Annex-Engineering/Denali/DXFs/Electronics_Backpack/electronics_box_side_panel_decorative_x2_rev1.DXF

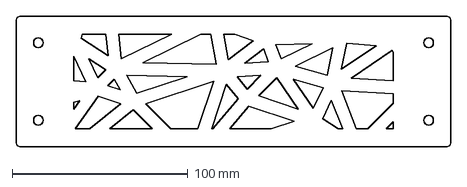
[picture p5: CAD file, 2020-09-06]
DXFs/Electronics_Backpack/electronics_box_side_panel_decorative_x2_rev1.DXF
247.0 x 74.0 mm
