Annex-Engineering/Denali/DXFs/Panels/Deck_Panel_350mm_Rev1.DXF

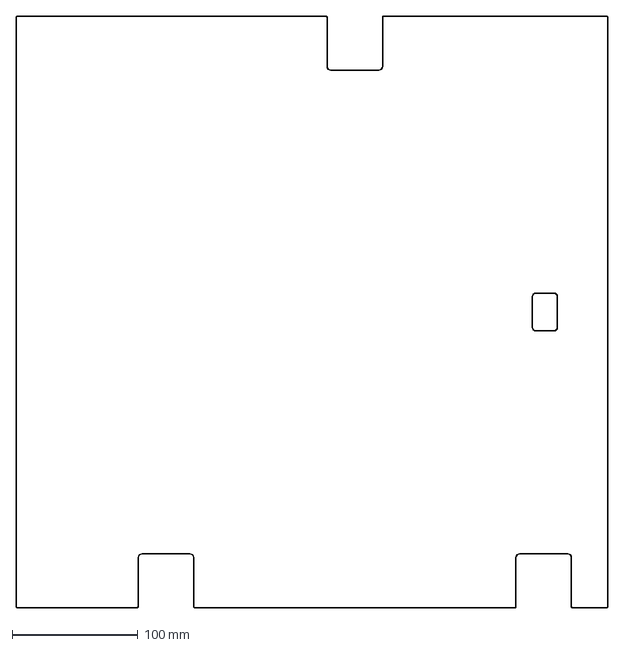
[picture p6: CAD file, 2020-09-06]
DXFs/Panels/Deck_Panel_350mm_Rev1.DXF
470.0 x 470.0 mm
