Annex-Engineering/Denali/STLs/Bed_and_Z_Drive/sfu1204_bed_pivot_joint_x1_Rev2.stl

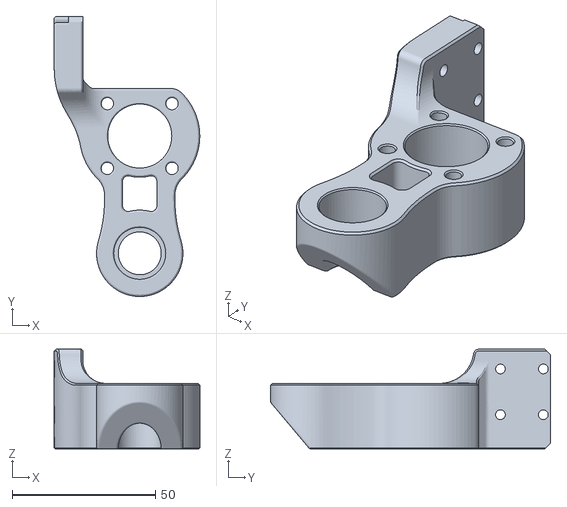
[picture p8: CAD file, 2020-09-06]
STLs/Bed_and_Z_Drive/sfu1204_bed_pivot_joint_x1_Rev2.stl
50.9 x 97.9 x 34.9
