Annex-Engineering/Denali/STLs/Display_Housing/fystec_mini_12864_housing_x1_Rev1.stl

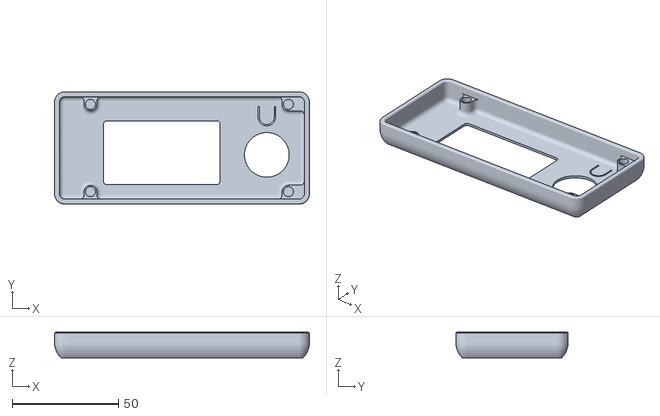
[picture p9: CAD file, 2020-09-06]
STLs/Display_Housing/fystec_mini_12864_housing_x1_Rev1.stl
119.8 x 52.8 x 12.0
