Annex-Engineering/Denali/STLs/Electronics_Brackets/[a]_electronics_box_corner_x4_rev7.STL

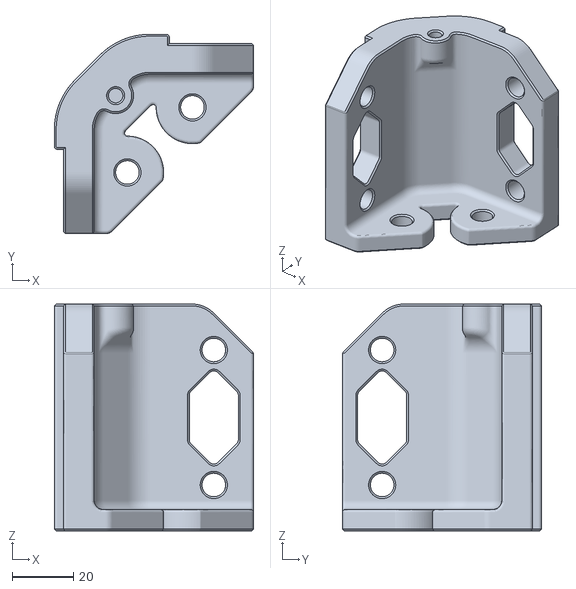
[picture p10: CAD file, 2022-02-27]
STLs/Electronics_Brackets/[a]_electronics_box_corner_x4_rev7.STL
65.0 x 65.0 x 74.0
