Annex-Engineering/Denali/STLs/Electronics_Mounting/bigtreetech_skr_mounting_bracket_x2_rev4.STL

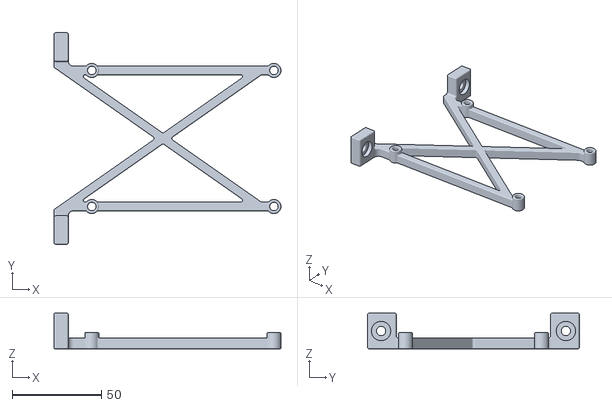
[picture p11: CAD file, 2021-05-22]
STLs/Electronics_Mounting/bigtreetech_skr_mounting_bracket_x2_rev4.STL
127.0 x 118.3 x 20.0
