Annex-Engineering/Denali/STLs/Filament_Management/External_to_Chamber/spool_holder_6mm_panels_x1_Rev1.stl

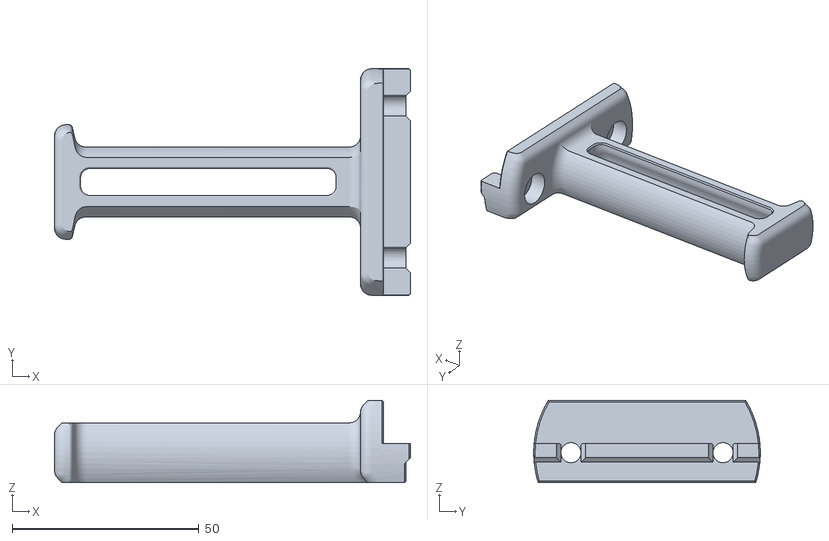
[picture p12: CAD file, 2020-09-06]
STLs/Filament_Management/External_to_Chamber/spool_holder_6mm_panels_x1_Rev1.stl
95.4 x 60.7 x 22.0
