Annex-Engineering/Denali/STLs/Filament_Management/In-Chamber/bowden_holder_in_chamber_spools_x1_rev1.STL

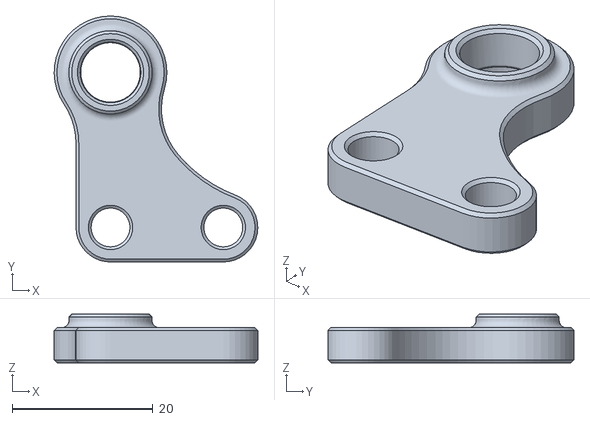
[picture p13: CAD file, 2020-09-06]
STLs/Filament_Management/In-Chamber/bowden_holder_in_chamber_spools_x1_rev1.STL
28.9 x 34.9 x 6.90
