Annex-Engineering/Denali/STLs/Gantry/AB_Drives/a_drive_frame_upper_x1_Rev2.stl

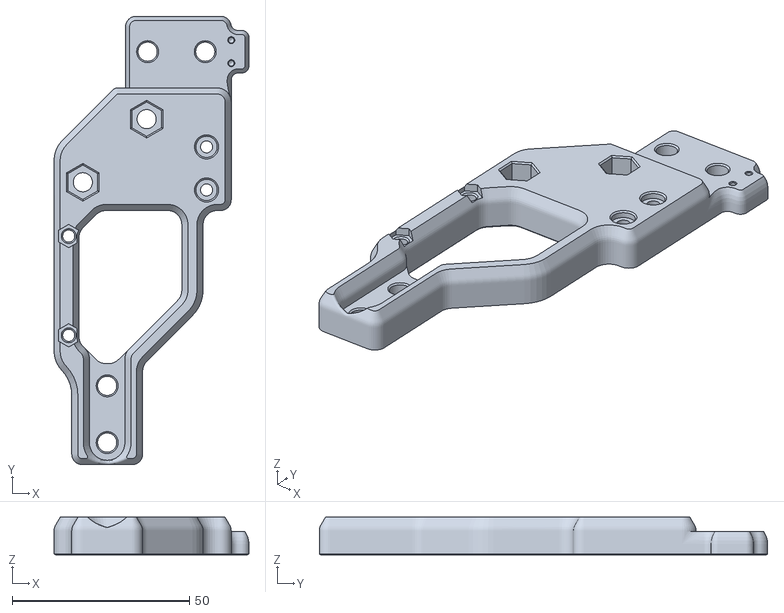
[picture p14: CAD file, 2020-09-06]
STLs/Gantry/AB_Drives/a_drive_frame_upper_x1_Rev2.stl
55.0 x 126.5 x 10.6
