Annex-Engineering/Denali/STLs/Gantry/Toolheads/mosquito_sherpa_mini_mount_rev1_x1.STL

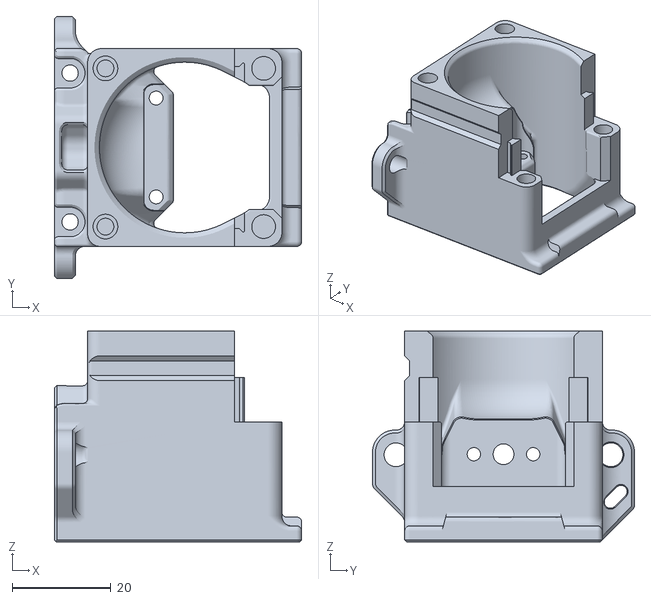
[picture p16: CAD file, 2021-01-14]
STLs/Gantry/Toolheads/mosquito_sherpa_mini_mount_rev1_x1.STL
50.0 x 53.0 x 42.6
