Annex-Engineering/Denali/STLs/Gantry/X_Carriage/x_carriage_left_mag_microswitch_rev1_x1.stl

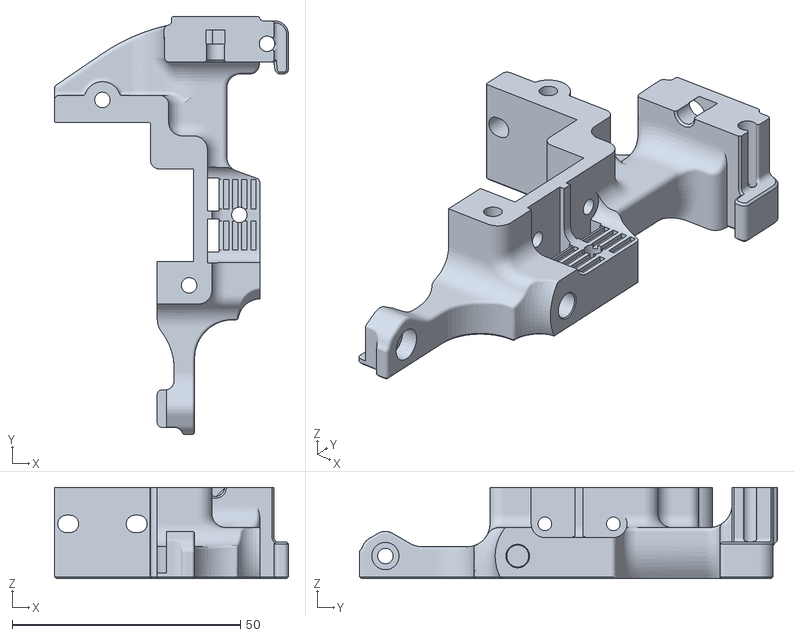
[picture p17: CAD file, 2021-01-16]
STLs/Gantry/X_Carriage/x_carriage_left_mag_microswitch_rev1_x1.stl
51.3 x 91.6 x 20.0
