Annex-Engineering/Denali/STLs/Gantry/XY_Joints/left_xy_joint_bottom_Rev3.stl

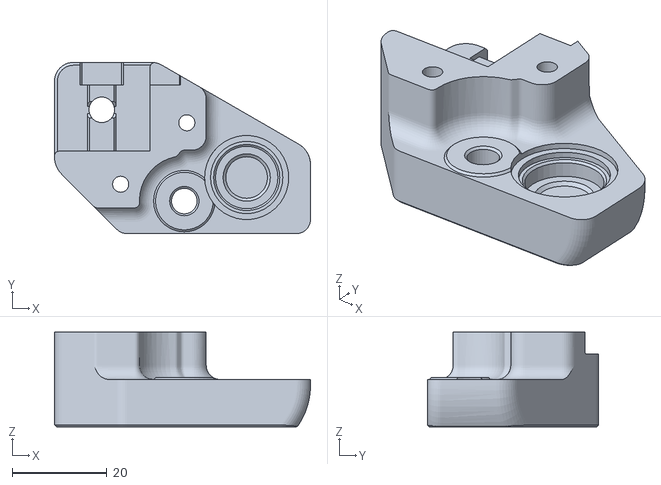
[picture p18: CAD file, 2020-09-06]
STLs/Gantry/XY_Joints/left_xy_joint_bottom_Rev3.stl
54.2 x 36.2 x 20.0
