Annex-Engineering/Denali/STLs/Magnetic_Probe_and_Dock/[a]_magnetic_probe_x1_rev1.STL

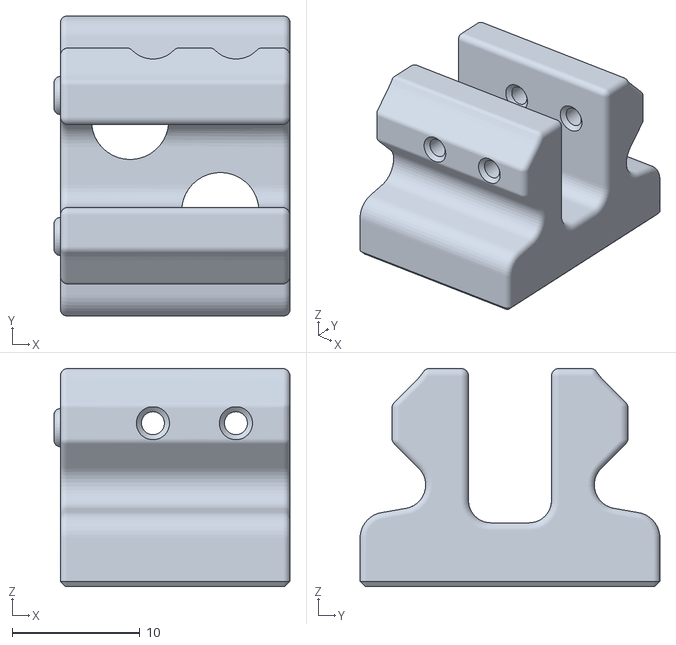
[picture p19: CAD file, 2020-09-06]
STLs/Magnetic_Probe_and_Dock/[a]_magnetic_probe_x1_rev1.STL
18.5 x 23.5 x 17.1
