Annex-Engineering/Denali/STLs/Misc/[a]_x_rail_installation_guide_x2_Rev2.stl

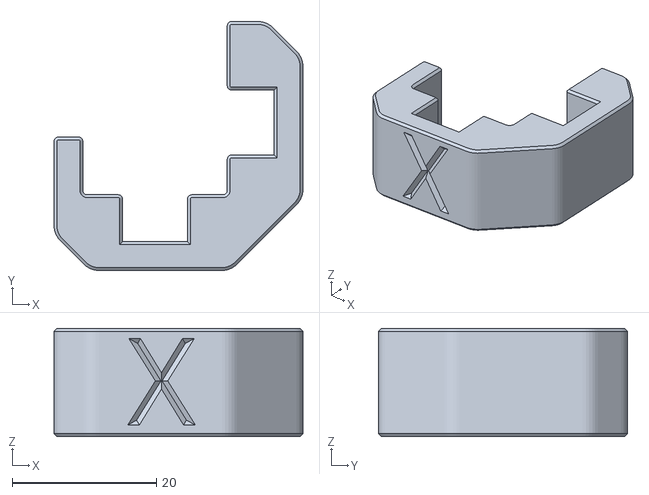
[picture p20: CAD file, 2020-09-06]
STLs/Misc/[a]_x_rail_installation_guide_x2_Rev2.stl
34.5 x 34.5 x 15.0
