Annex-Engineering/Denali/STLs/Panel_Mounting/Front_Panel_Hinges_and_Locks/Hinges/hinge_frame_bottom_6mm_x2_rev1.STL

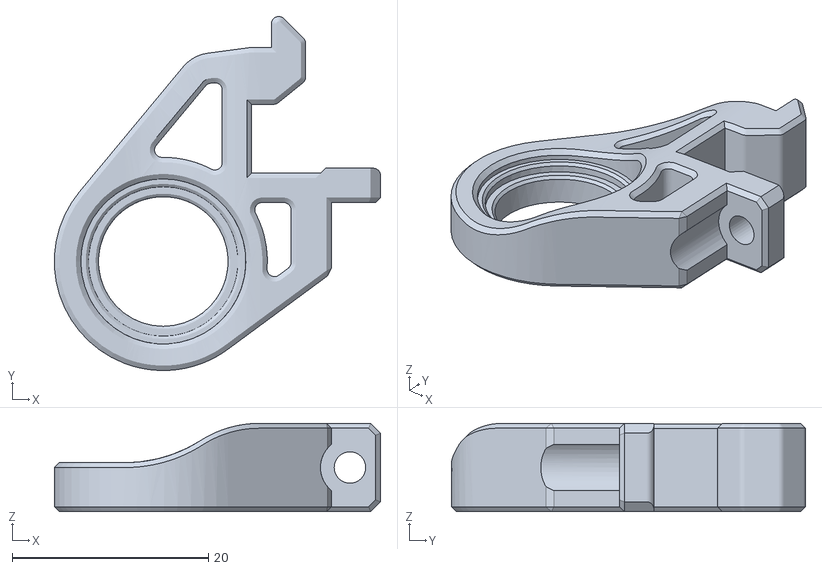
[picture p21: CAD file, 2020-09-06]
STLs/Panel_Mounting/Front_Panel_Hinges_and_Locks/Hinges/hinge_frame_bottom_6mm_x2_rev1.STL
33.2 x 36.0 x 9.00
