Annex-Engineering/Denali/STLs/Panel_Mounting/Front_Panel_Hinges_and_Locks/Locks/lock_body_6mm_x2_Rev1.stl

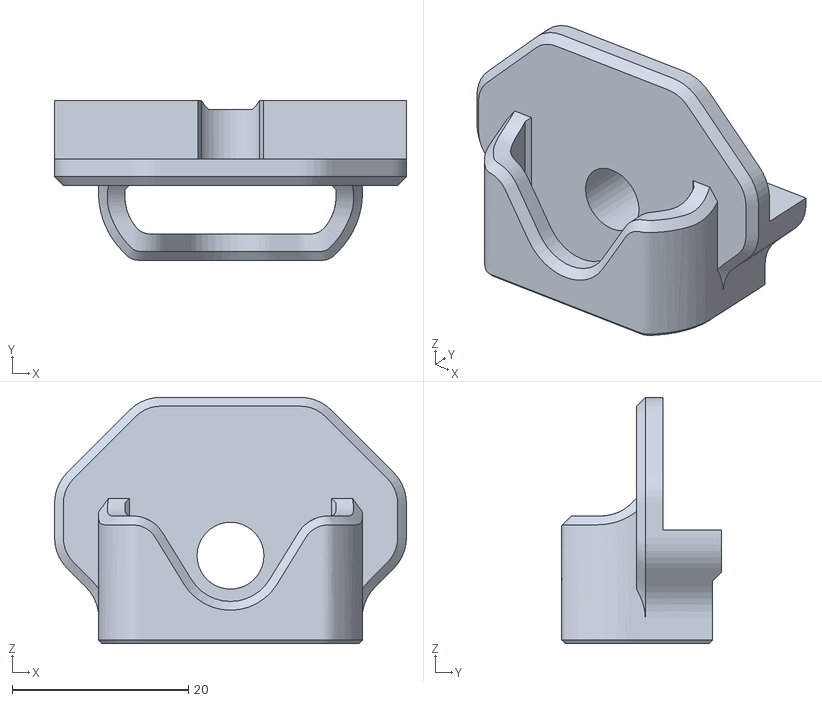
[picture p22: CAD file, 2020-09-06]
STLs/Panel_Mounting/Front_Panel_Hinges_and_Locks/Locks/lock_body_6mm_x2_Rev1.stl
40.0 x 18.1 x 28.0
