Annex-Engineering/Denali/STLs/Panel_Mounting/Side_Top_and_Rear_Panel_Quick_Release/lock_body_6mm_x20_Rev2.stl

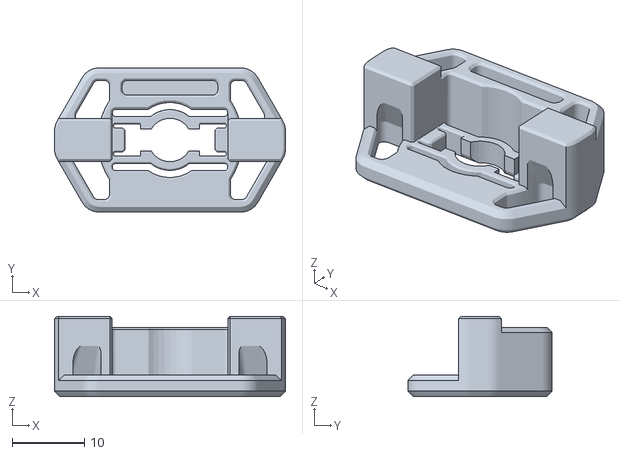
[picture p23: CAD file, 2020-09-06]
STLs/Panel_Mounting/Side_Top_and_Rear_Panel_Quick_Release/lock_body_6mm_x20_Rev2.stl
32.0 x 20.0 x 11.1
