Annex-Engineering/Denali/STLs/Z_Endstop/z_endstop_housing_key_x1_rev1.STL

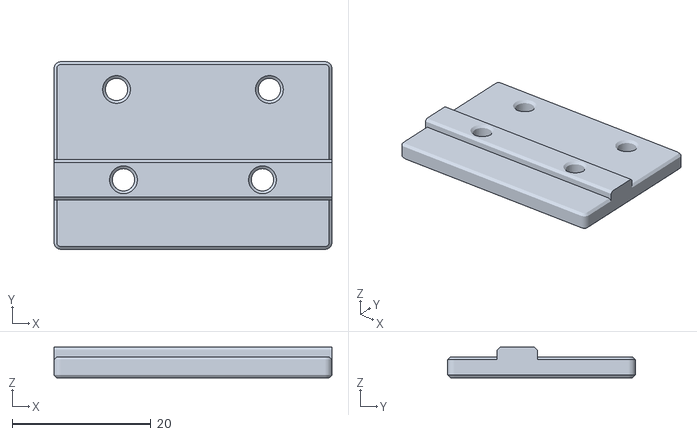
[picture p24: CAD file, 2020-09-06]
STLs/Z_Endstop/z_endstop_housing_key_x1_rev1.STL
40.0 x 27.0 x 4.40
