Annex-Engineering/Denali/DXFs/Panels/Deck_Panel_300mm_Rev1.DXF

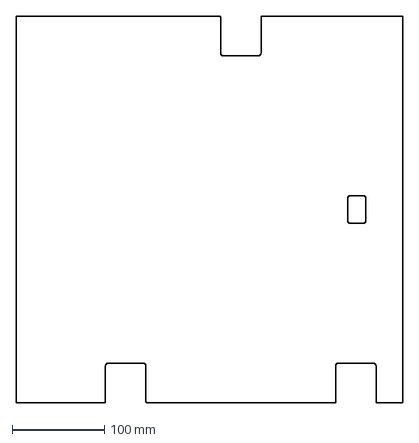
[picture p26: CAD file, 2020-09-06]
DXFs/Panels/Deck_Panel_300mm_Rev1.DXF
420.0 x 420.0 mm
