Annex-Engineering/Denali/DXFs/Skirts/Front_Skirt_With_Screen_200mm_Rev1.DXF

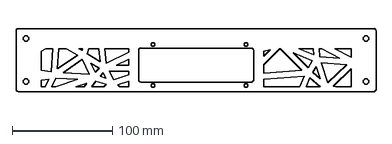
[picture p27: CAD file, 2020-09-06]
DXFs/Skirts/Front_Skirt_With_Screen_200mm_Rev1.DXF
360.0 x 63.0 mm
