Annex-Engineering/Denali/STLs/Electronics_Brackets/universal_meanwell_lrs_psu_mounting_bracket_x2_rev3.STL

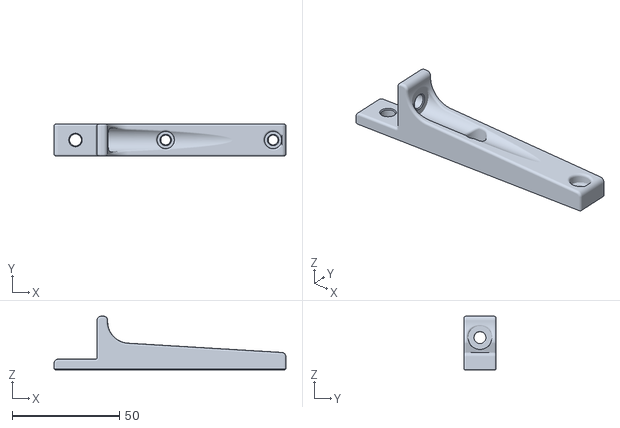
[picture p28: CAD file, 2022-02-11]
STLs/Electronics_Brackets/universal_meanwell_lrs_psu_mounting_bracket_x2_rev3.STL
108.0 x 15.0 x 25.0
