Annex-Engineering/Denali/STLs/Electronics_Mounting/bigtreetech_skr_mounting_bracket_with_motor_expander_x1_rev3.STL

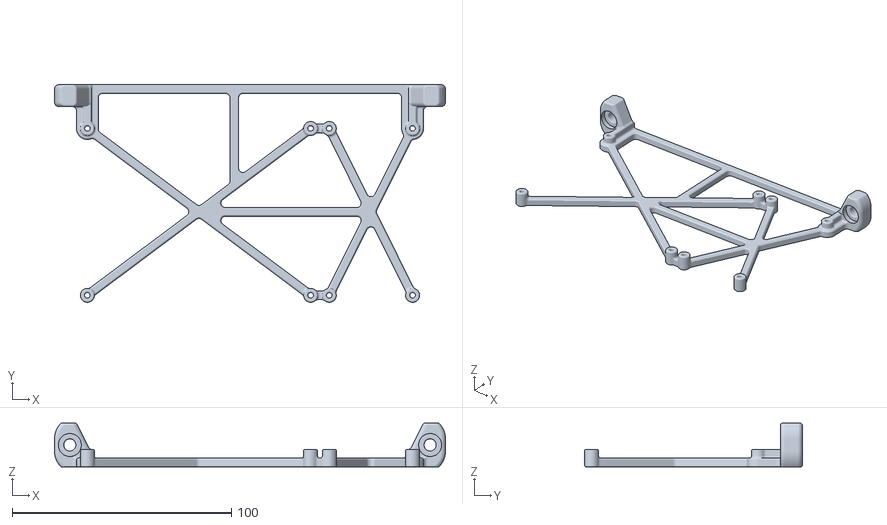
[picture p29: CAD file, 2021-01-14]
STLs/Electronics_Mounting/bigtreetech_skr_mounting_bracket_with_motor_expander_x1_rev3.STL
178.3 x 99.3 x 20.0
