Annex-Engineering/Denali/STLs/Filament_Management/External_to_Chamber/[a]_filament_sensor_holder_x2_rev1.STL

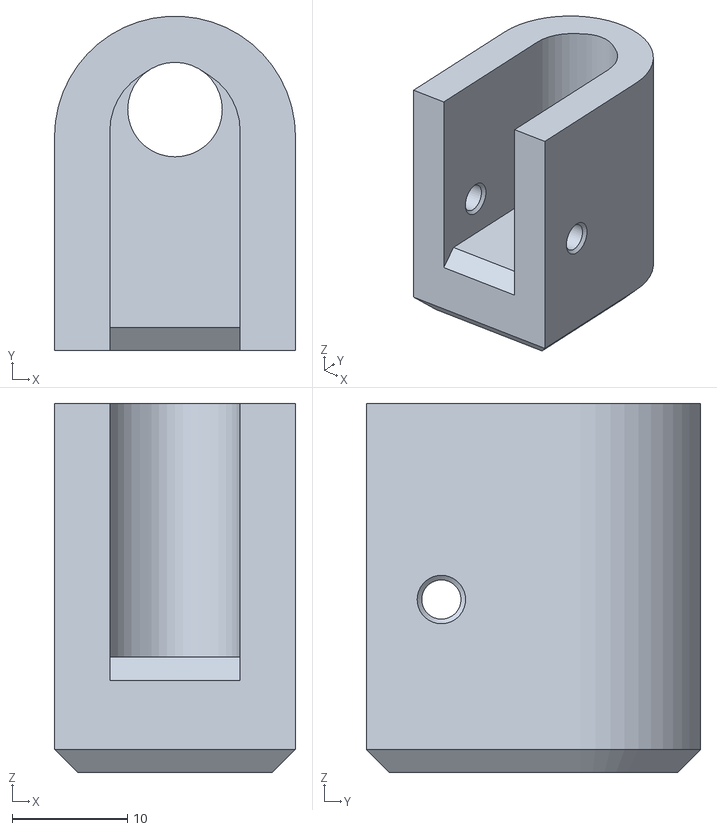
[picture p30: CAD file, 2020-09-06]
STLs/Filament_Management/External_to_Chamber/[a]_filament_sensor_holder_x2_rev1.STL
20.9 x 29.0 x 32.0
