Annex-Engineering/Denali/STLs/Filament_Management/In-Chamber/spool_holder_frame_x2_rev2.STL

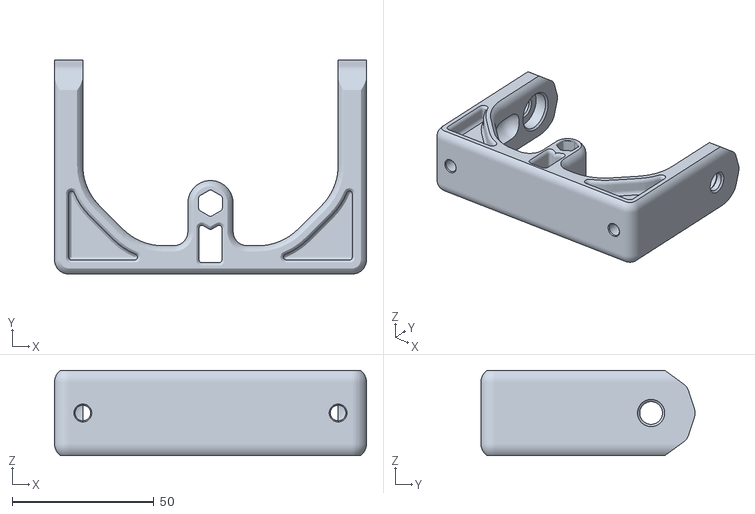
[picture p31: CAD file, 2020-09-06]
STLs/Filament_Management/In-Chamber/spool_holder_frame_x2_rev2.STL
110.0 x 75.5 x 30.0
