Annex-Engineering/Denali/STLs/Gantry/AB_Drives/b_drive_frame_lower_x1_Rev2.stl

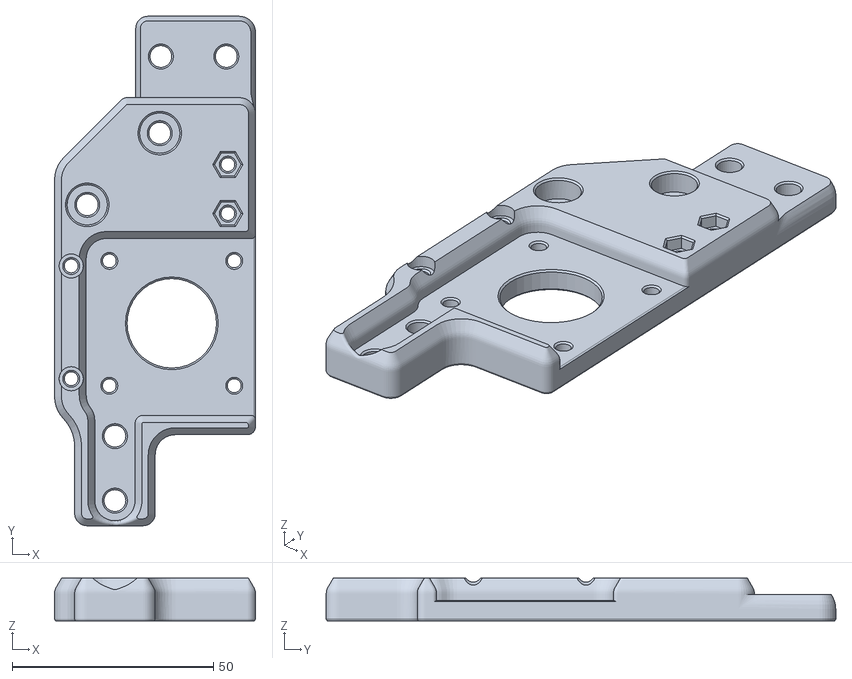
[picture p32: CAD file, 2020-09-06]
STLs/Gantry/AB_Drives/b_drive_frame_lower_x1_Rev2.stl
49.9 x 126.5 x 10.6
