Annex-Engineering/Denali/STLs/Gantry/Front_Idlers/[a]_front_idler_a_upper_cap_x1_Rev1.stl

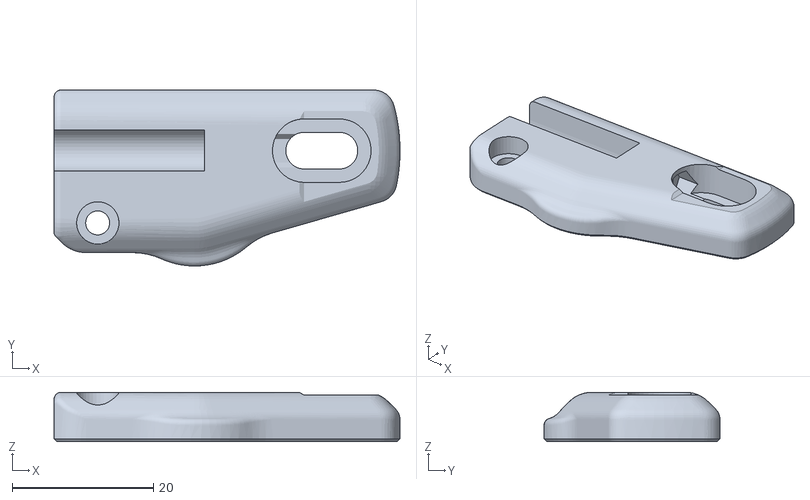
[picture p33: CAD file, 2020-09-06]
STLs/Gantry/Front_Idlers/[a]_front_idler_a_upper_cap_x1_Rev1.stl
49.1 x 25.0 x 7.00
