Annex-Engineering/Denali/STLs/Gantry/Toolheads/dragon_sherpa_mini_mount_single_unit_rev1_x1.stl

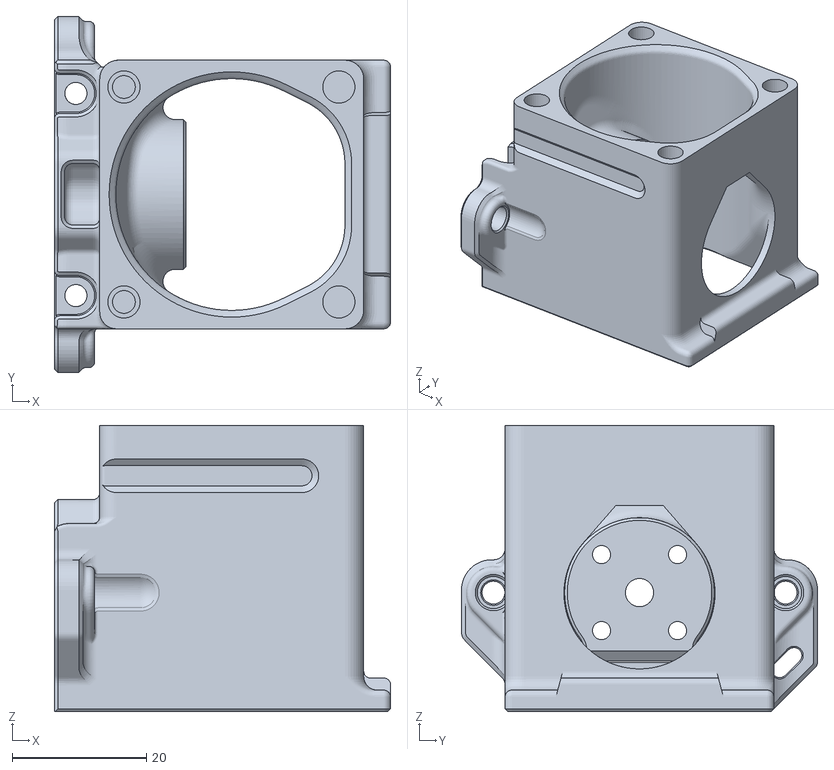
[picture p34: CAD file, 2021-01-14]
STLs/Gantry/Toolheads/dragon_sherpa_mini_mount_single_unit_rev1_x1.stl
50.0 x 53.0 x 42.6
