Annex-Engineering/Denali/STLs/Gantry/X_Carriage/x_carriage_right_mag_microswitch_rev1_x1.stl

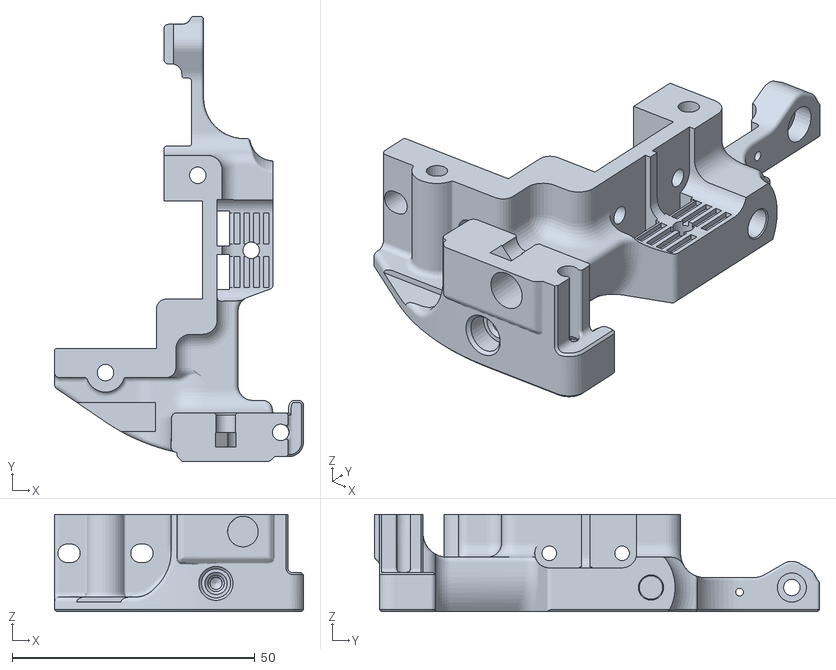
[picture p35: CAD file, 2021-01-14]
STLs/Gantry/X_Carriage/x_carriage_right_mag_microswitch_rev1_x1.stl
51.3 x 91.6 x 20.0
