Annex-Engineering/Denali/STLs/Gantry/XY_Joints/left_xy_joint_top_Rev4.stl

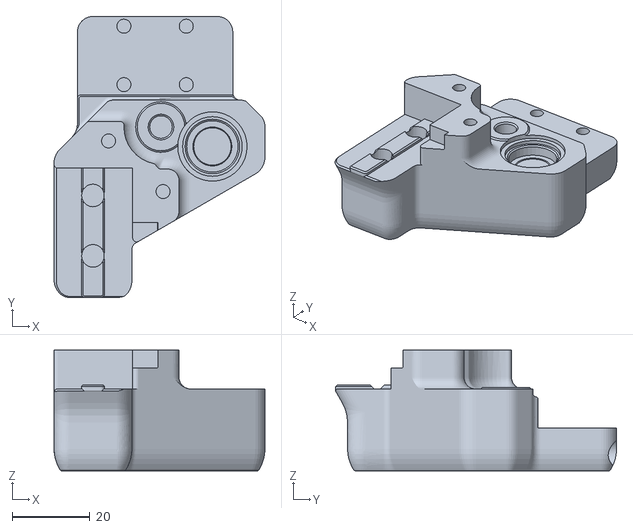
[picture p36: CAD file, 2020-09-06]
STLs/Gantry/XY_Joints/left_xy_joint_top_Rev4.stl
54.2 x 72.2 x 31.0
