Annex-Engineering/Denali/STLs/Magnetic_Probe_and_Dock/probe_dock_plate_gantry_adapter_x1_rev2.STL

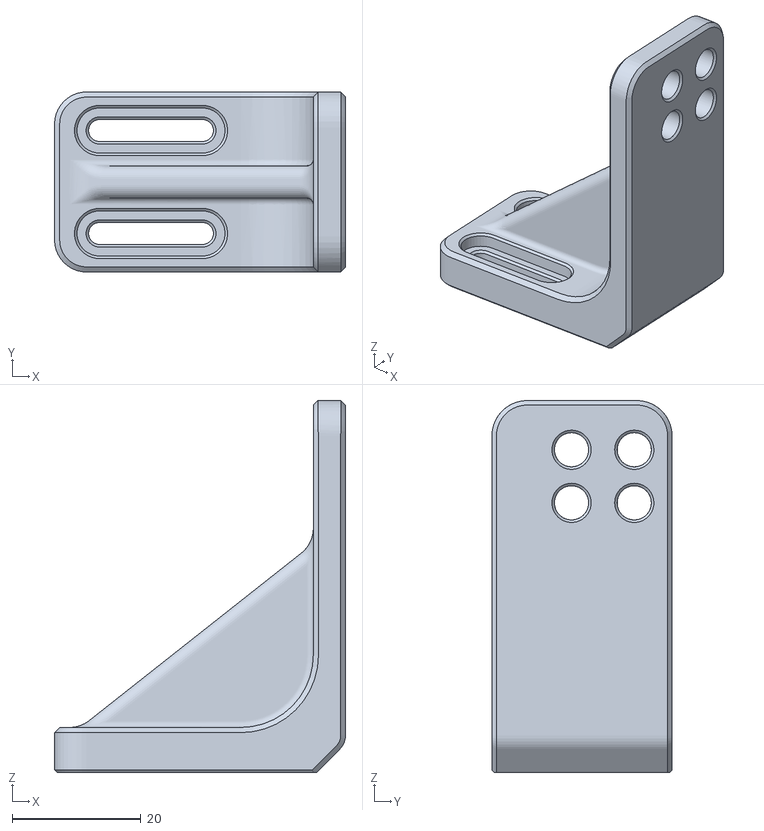
[picture p37: CAD file, 2020-09-06]
STLs/Magnetic_Probe_and_Dock/probe_dock_plate_gantry_adapter_x1_rev2.STL
45.2 x 28.0 x 57.8
