Annex-Engineering/Denali/STLs/Misc/[a]_z_rail_installation_guide_x2_Rev2.stl

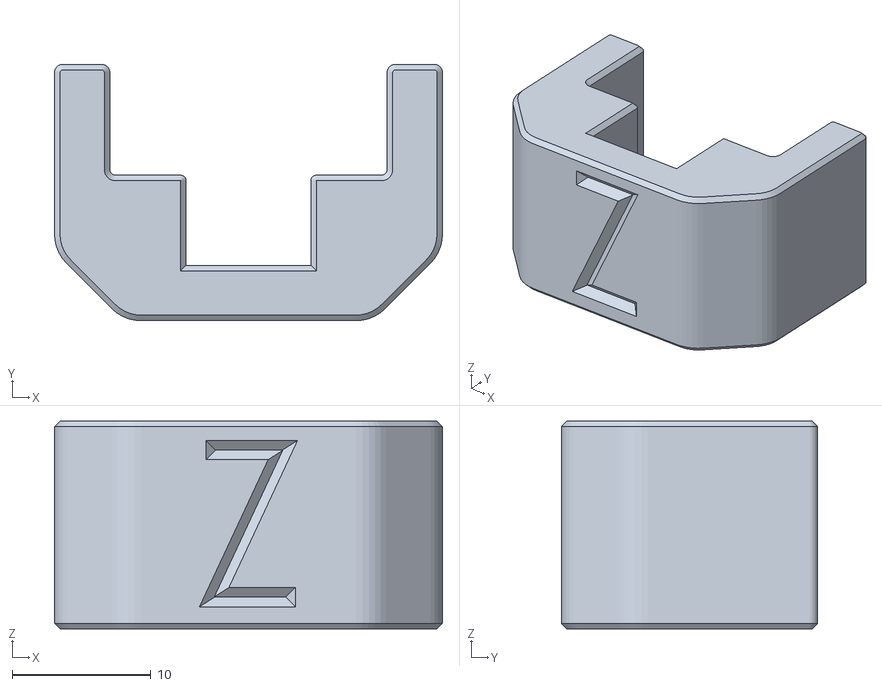
[picture p38: CAD file, 2020-09-06]
STLs/Misc/[a]_z_rail_installation_guide_x2_Rev2.stl
28.0 x 18.5 x 15.0
