Annex-Engineering/Denali/STLs/Panel_Mounting/Front_Panel_Hinges_and_Locks/Hinges/[a]_hinge_arm_6mm_x2_rev1.STL

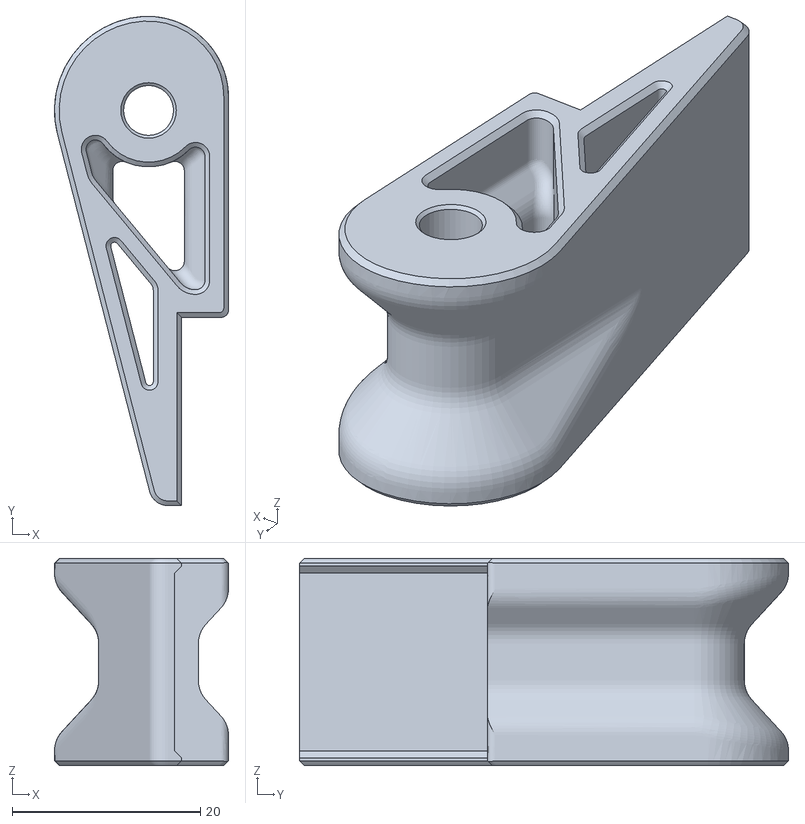
[picture p39: CAD file, 2020-09-06]
STLs/Panel_Mounting/Front_Panel_Hinges_and_Locks/Hinges/[a]_hinge_arm_6mm_x2_rev1.STL
18.5 x 52.0 x 22.0
