Annex-Engineering/Denali/STLs/Panel_Mounting/Front_Panel_Hinges_and_Locks/Locks/[a]_latch_rhs_6mm_x2_Rev1.stl

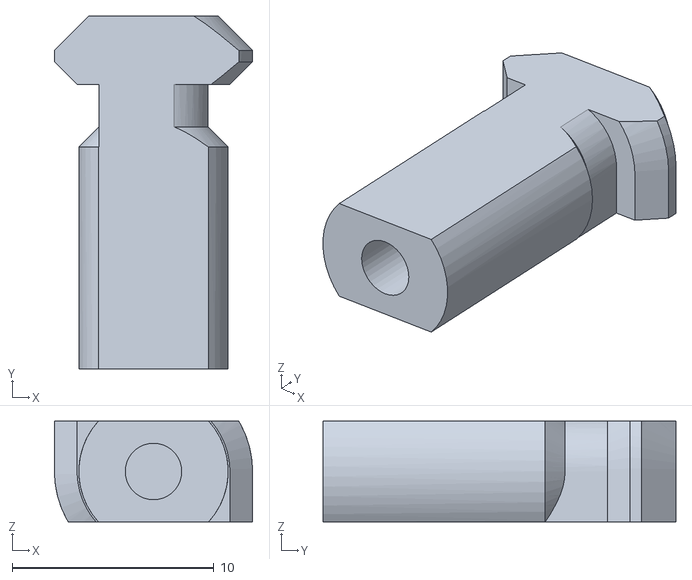
[picture p40: CAD file, 2020-09-06]
STLs/Panel_Mounting/Front_Panel_Hinges_and_Locks/Locks/[a]_latch_rhs_6mm_x2_Rev1.stl
9.82 x 17.5 x 5.00
