Annex-Engineering/Denali/STLs/Panel_Mounting/Side_Top_and_Rear_Panel_Quick_Release/[a]_key_6mm_x58_Rev2.stl

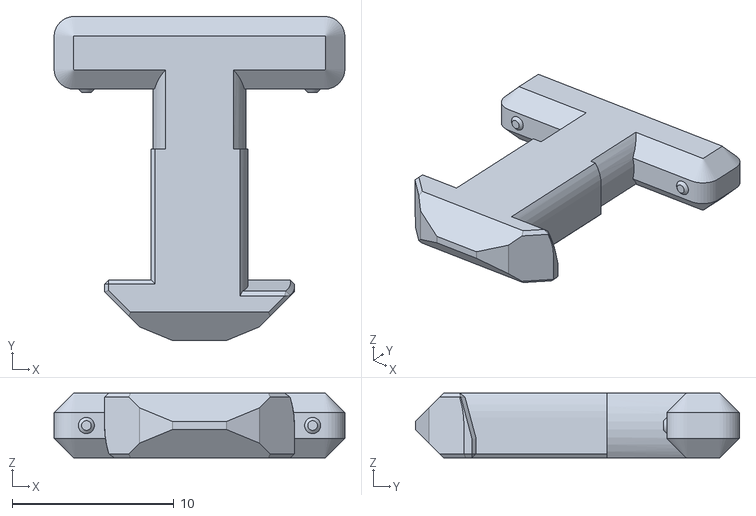
[picture p41: CAD file, 2020-09-06]
STLs/Panel_Mounting/Side_Top_and_Rear_Panel_Quick_Release/[a]_key_6mm_x58_Rev2.stl
18.0 x 20.0 x 4.00
