Annex-Engineering/Denali/STLs/Z_Endstop/z_endstop_housing_x1_rev1.STL

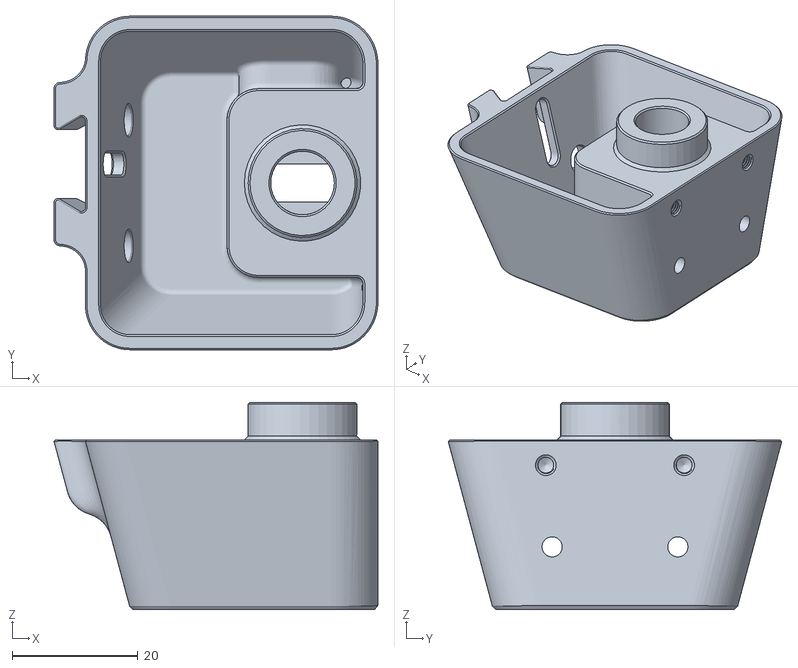
[picture p42: CAD file, 2020-09-06]
STLs/Z_Endstop/z_endstop_housing_x1_rev1.STL
51.5 x 53.1 x 33.0
