Annex-Engineering/Denali/DXFs/Electronics_Backpack/electronics_box_cover_x1_rev2.DXF

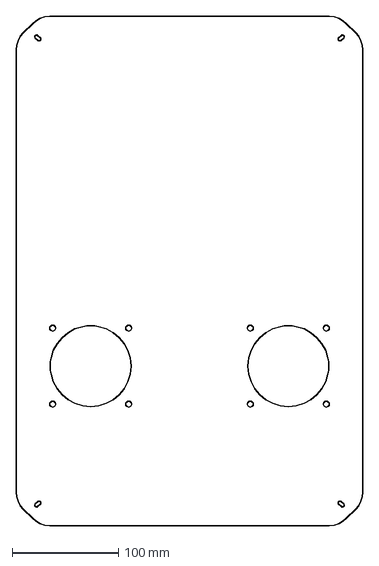
[picture p43: CAD file, 2020-09-06]
DXFs/Electronics_Backpack/electronics_box_cover_x1_rev2.DXF
326.0 x 479.0 mm
