Annex-Engineering/Denali/DXFs/Panels/Back_Panel_250mm_Rev1.DXF

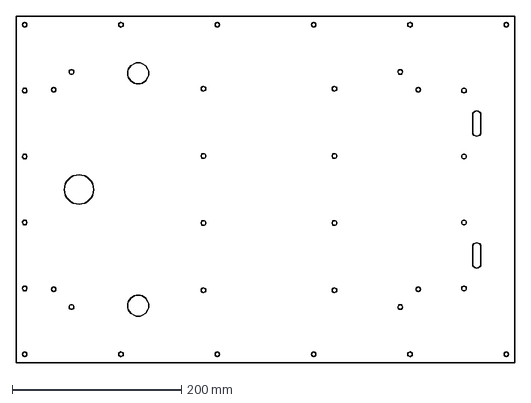
[picture p44: CAD file, 2020-09-06]
DXFs/Panels/Back_Panel_250mm_Rev1.DXF
590.0 x 410.0 mm
