Annex-Engineering/Denali/DXFs/Skirts/Side_Skirt_200mm_Rev2.DXF

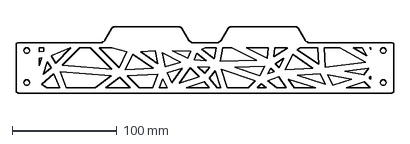
[picture p45: CAD file, 2020-09-06]
DXFs/Skirts/Side_Skirt_200mm_Rev2.DXF
360.0 x 63.0 mm
