Annex-Engineering/Denali/STLs/Gantry/AB_Drives/[a]_front_frame_brace_x2_Rev1.stl

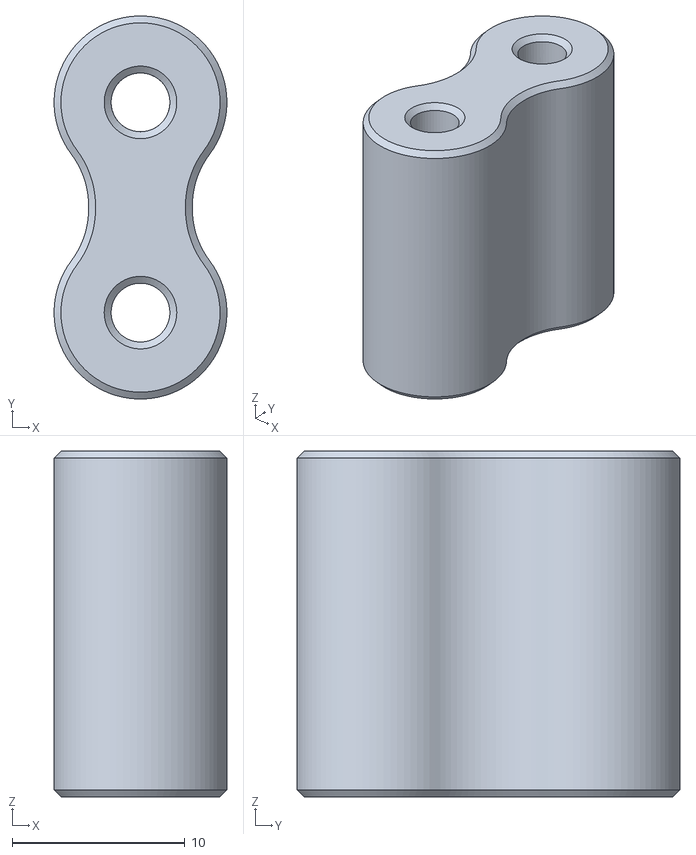
[picture p47: CAD file, 2020-09-06]
STLs/Gantry/AB_Drives/[a]_front_frame_brace_x2_Rev1.stl
10.00 x 22.2 x 20.0
