Annex-Engineering/Denali/STLs/Gantry/Toolheads/[a]_front_plate_rev1_x1.stl

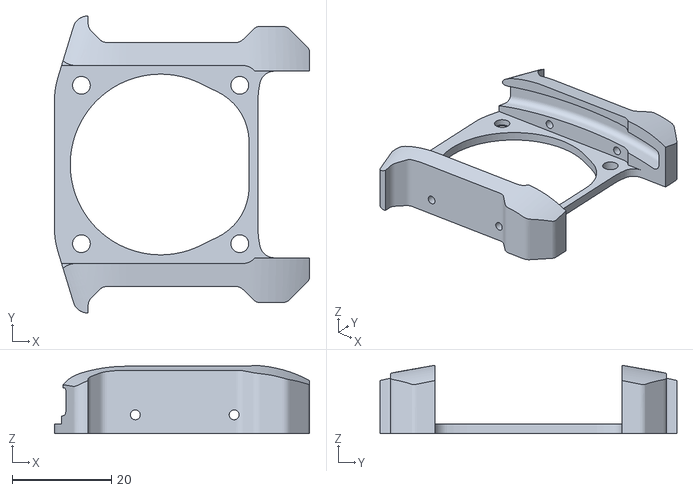
[picture p48: CAD file, 2021-01-14]
STLs/Gantry/Toolheads/[a]_front_plate_rev1_x1.stl
51.6 x 60.0 x 13.8
