Annex-Engineering/Denali/STLs/Gantry/X_Carriage/umbilical_support_lance_rev1_x1.stl

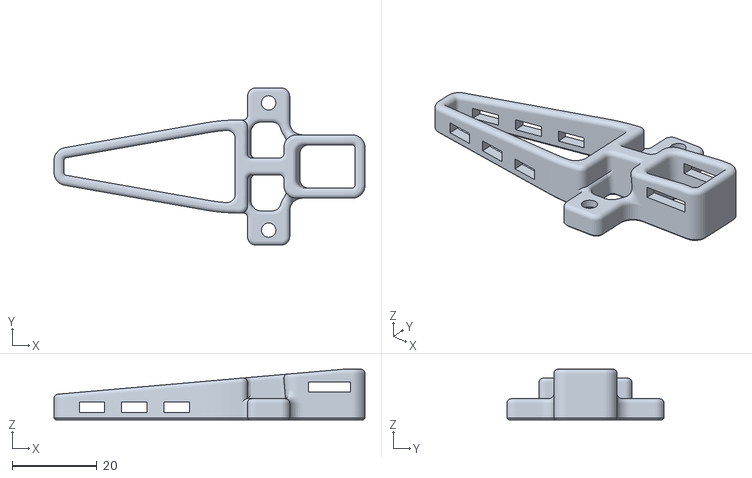
[picture p49: CAD file, 2021-01-14]
STLs/Gantry/X_Carriage/umbilical_support_lance_rev1_x1.stl
73.6 x 37.2 x 12.0
