Annex-Engineering/Denali/STLs/Magnetic_Probe_and_Dock/probe_dock_midplate_x1_rev1.STL

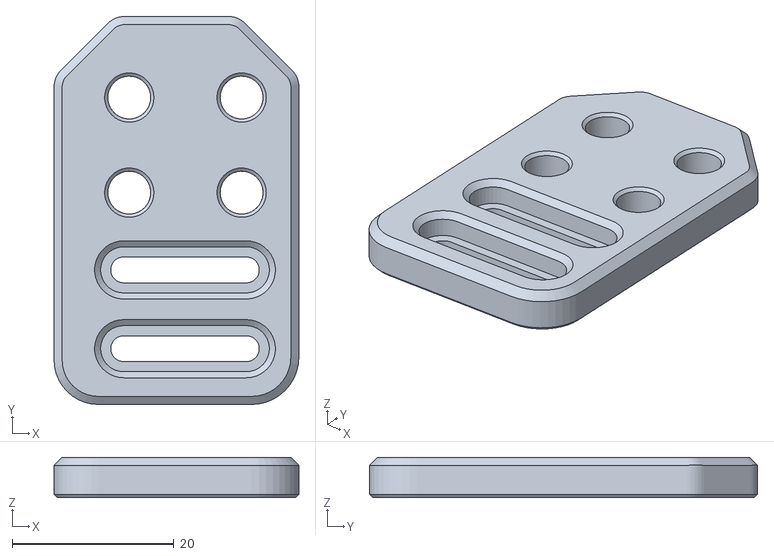
[picture p50: CAD file, 2020-09-06]
STLs/Magnetic_Probe_and_Dock/probe_dock_midplate_x1_rev1.STL
30.3 x 48.0 x 5.00
