Annex-Engineering/Denali/STLs/Misc/z_overtravel_e_stop_x3_rev1.STL

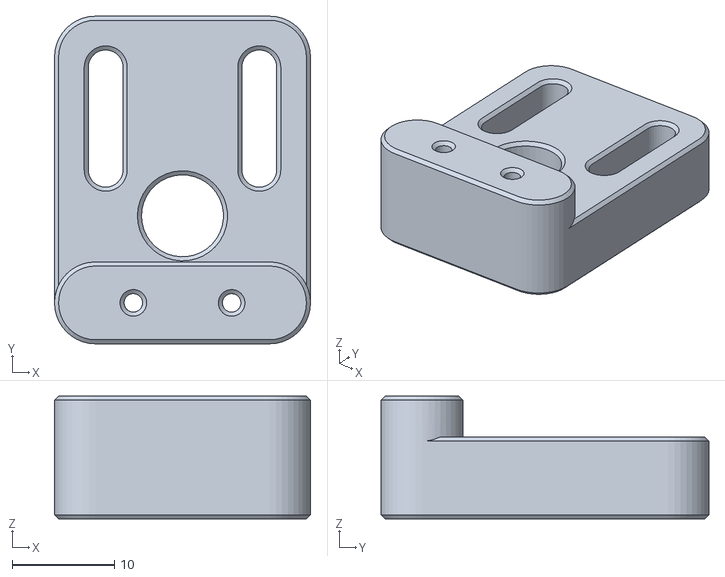
[picture p51: CAD file, 2020-09-06]
STLs/Misc/z_overtravel_e_stop_x3_rev1.STL
25.0 x 32.0 x 12.0
