Annex-Engineering/Denali/STLs/Panel_Mounting/Front_Panel_Hinges_and_Locks/Locks/[a]_lock_lever_rhs_x2_Rev1.stl

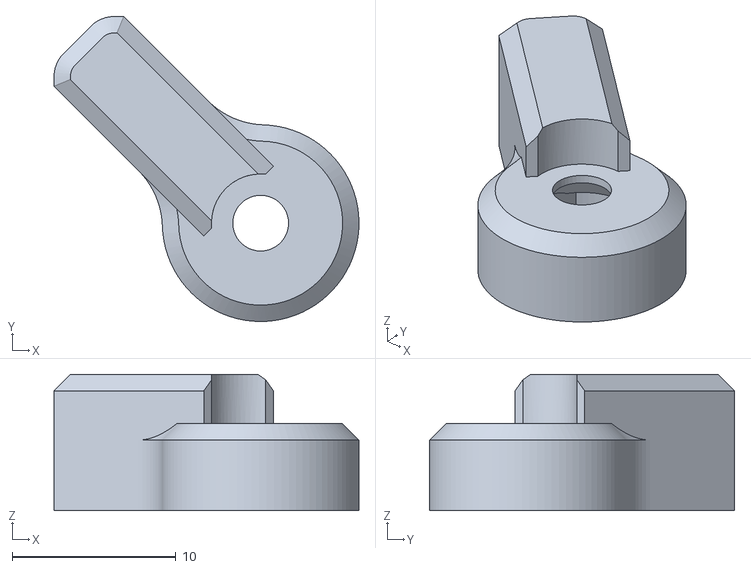
[picture p52: CAD file, 2020-09-06]
STLs/Panel_Mounting/Front_Panel_Hinges_and_Locks/Locks/[a]_lock_lever_rhs_x2_Rev1.stl
18.6 x 18.6 x 8.30
