Annex-Engineering/Denali/STLs/Panel_Mounting/Side_Top_and_Rear_Panel_Quick_Release/lock_body_filament_switch_6mm_x1_Rev1.stl

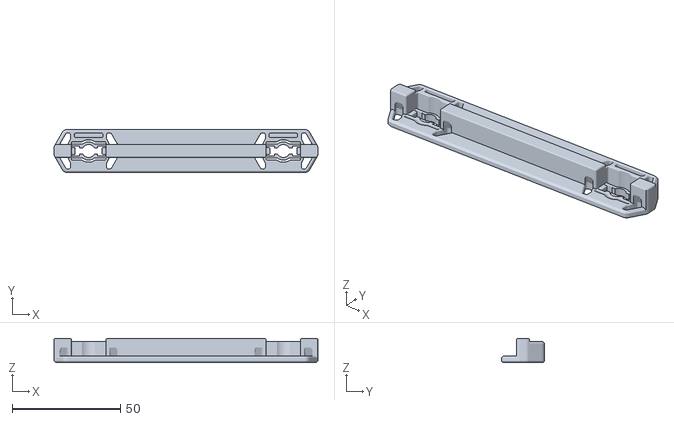
[picture p53: CAD file, 2020-09-06]
STLs/Panel_Mounting/Side_Top_and_Rear_Panel_Quick_Release/lock_body_filament_switch_6mm_x1_Rev1.stl
122.0 x 20.0 x 11.1
