Annex-Engineering/Denali/STLs/Z_Endstop/z_endstop_brush_mount_x1_rev1.STL

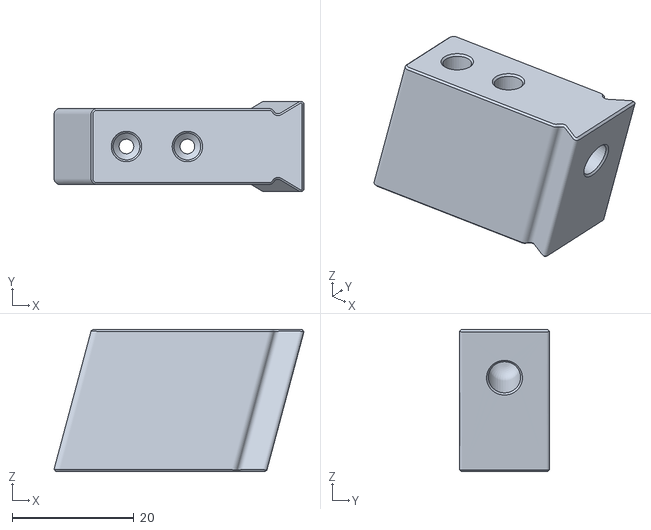
[picture p54: CAD file, 2020-09-06]
STLs/Z_Endstop/z_endstop_brush_mount_x1_rev1.STL
41.0 x 14.8 x 23.3
