Annex-Engineering/Denali/DXFs/Electronics_Backpack/electronics_box_side_panel_decorative_x1_rev2.DXF

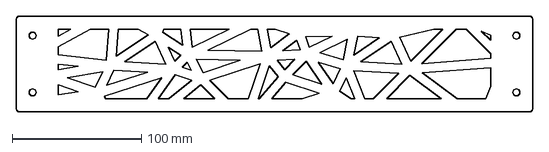
[picture p55: CAD file, 2020-09-06]
DXFs/Electronics_Backpack/electronics_box_side_panel_decorative_x1_rev2.DXF
400.0 x 74.0 mm
