Annex-Engineering/Denali/DXFs/Panels/Deck_Panel_250mm_Rev1.DXF

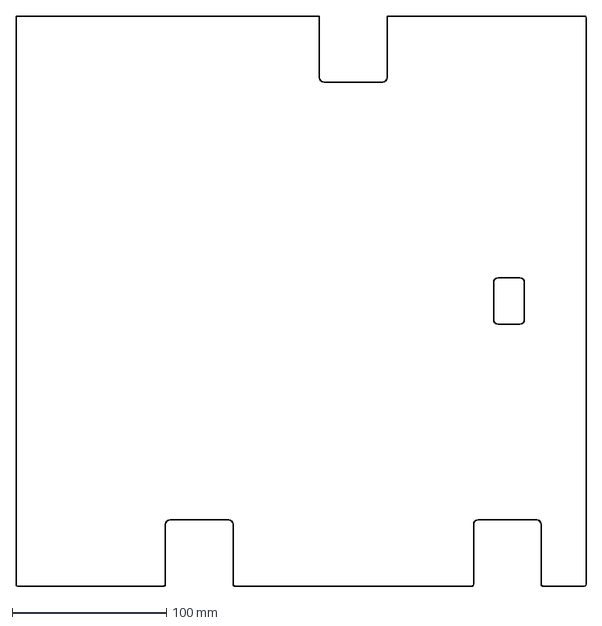
[picture p56: CAD file, 2020-09-06]
DXFs/Panels/Deck_Panel_250mm_Rev1.DXF
370.0 x 370.0 mm
