Annex-Engineering/Denali/STLs/Electronics_Brackets/universal_meanwell_uhp_psu_mounting_bracket_x2_rev2.STL

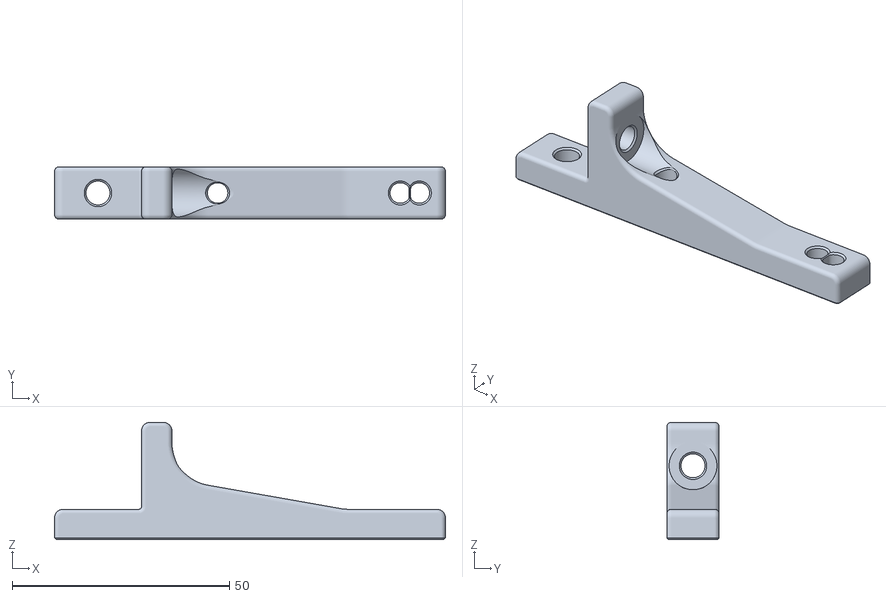
[picture p58: CAD file, 2022-02-01]
STLs/Electronics_Brackets/universal_meanwell_uhp_psu_mounting_bracket_x2_rev2.STL
89.9 x 12.0 x 27.0
