Annex-Engineering/Denali/STLs/Gantry/AB_Drives/[a]_rear_frame_brace_x2_Rev1.stl

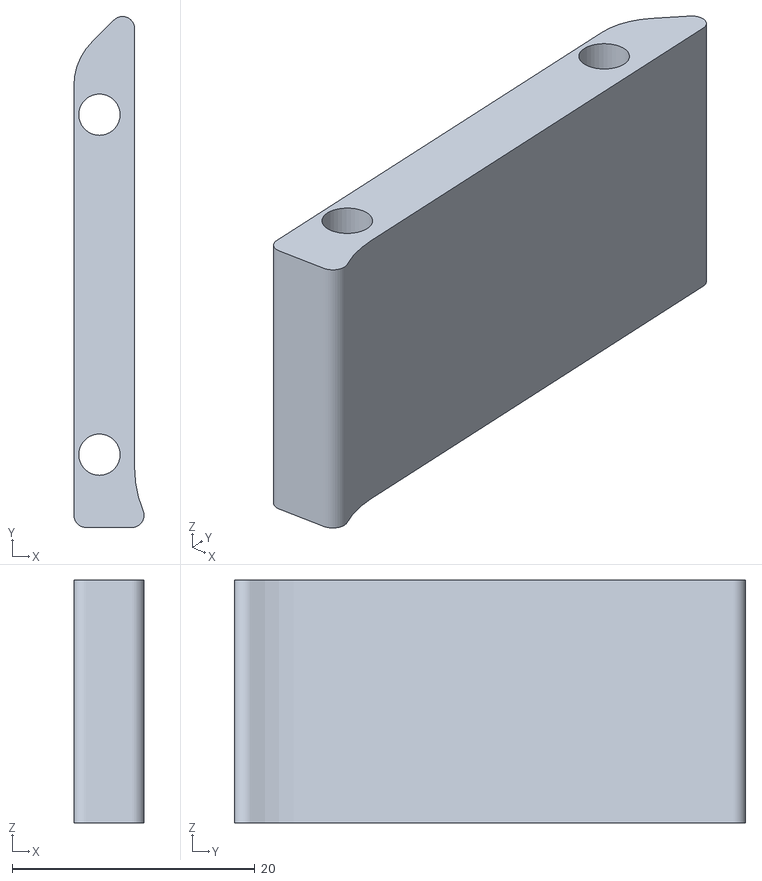
[picture p59: CAD file, 2020-09-06]
STLs/Gantry/AB_Drives/[a]_rear_frame_brace_x2_Rev1.stl
5.78 x 42.1 x 20.0
