Annex-Engineering/Denali/STLs/Gantry/Toolheads/V6_sherpa_mini_mount_back_rev1_x1.STL

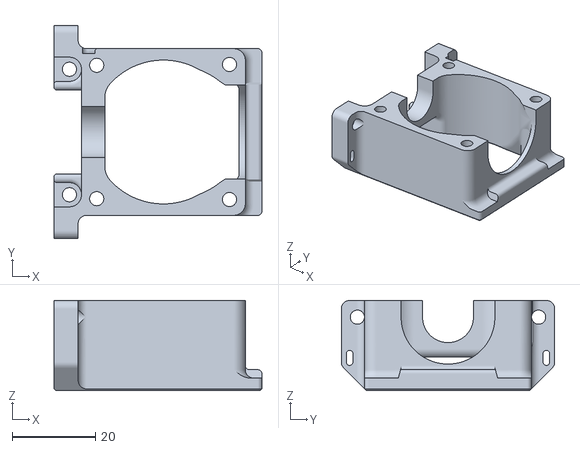
[picture p61: CAD file, 2021-01-14]
STLs/Gantry/Toolheads/V6_sherpa_mini_mount_back_rev1_x1.STL
49.9 x 51.2 x 21.6
