Annex-Engineering/Denali/STLs/Magnetic_Probe_and_Dock/probe_dock_fork_x1_rev2.STL

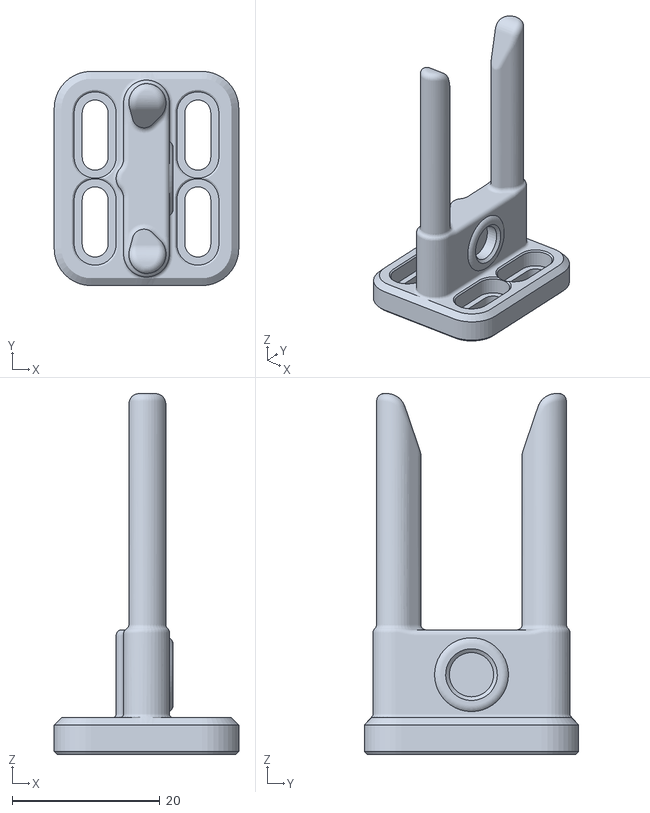
[picture p62: CAD file, 2020-09-06]
STLs/Magnetic_Probe_and_Dock/probe_dock_fork_x1_rev2.STL
25.0 x 29.0 x 48.9
