Annex-Engineering/Denali/STLs/Panel_Mounting/Side_Top_and_Rear_Panel_Quick_Release/corner_lock_body_6mm_x6_Rev2.stl

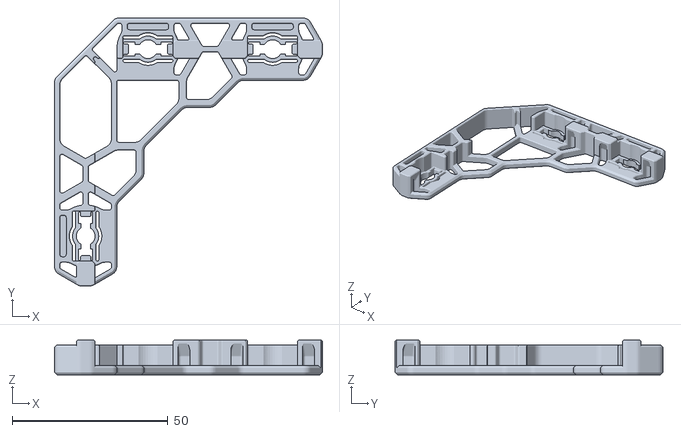
[picture p64: CAD file, 2020-09-06]
STLs/Panel_Mounting/Side_Top_and_Rear_Panel_Quick_Release/corner_lock_body_6mm_x6_Rev2.stl
86.0 x 86.0 x 11.1
