Annex-Engineering/Denali/DXFs/Panels/Back_Panel_300mm_Rev1.DXF

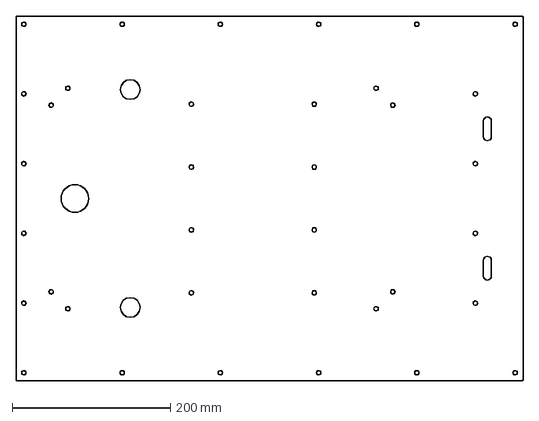
[picture p65: CAD file, 2020-09-06]
DXFs/Panels/Back_Panel_300mm_Rev1.DXF
640.0 x 460.0 mm
