Annex-Engineering/Denali/DXFs/Skirts/Side_Skirt_300mm_Rev2.DXF

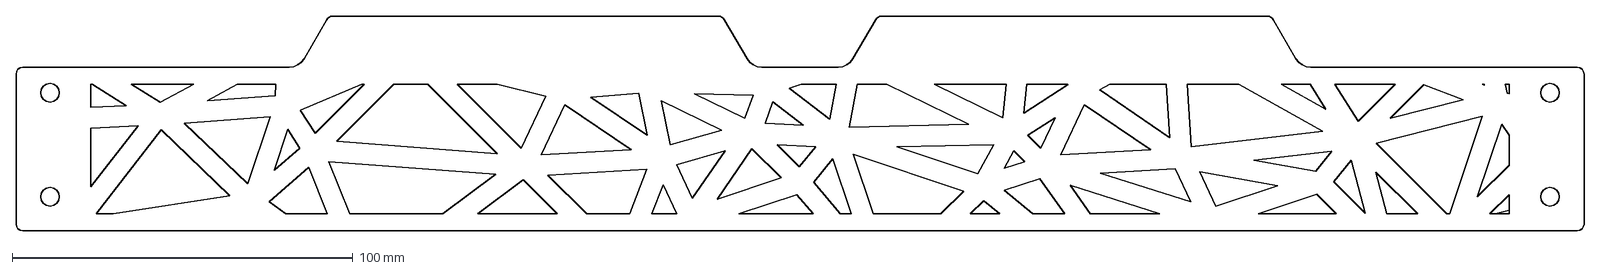
[picture p66: CAD file, 2020-09-06]
DXFs/Skirts/Side_Skirt_300mm_Rev2.DXF
460.0 x 63.0 mm
