Annex-Engineering/Denali/STLs/Gantry/Front_Idlers/front_idler_2_x2_Rev1.stl

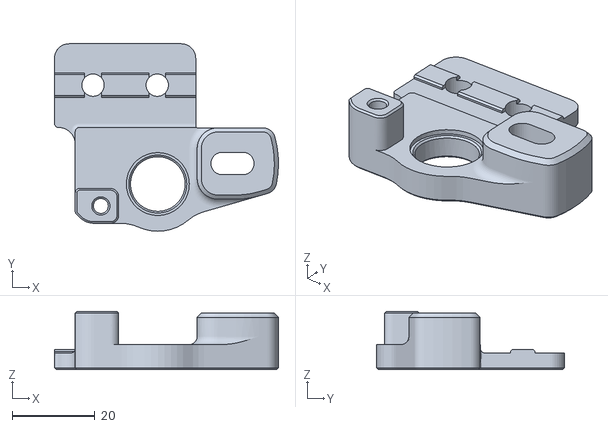
[picture p68: CAD file, 2020-09-06]
STLs/Gantry/Front_Idlers/front_idler_2_x2_Rev1.stl
54.1 x 45.3 x 14.0
