Annex-Engineering/Denali/STLs/Gantry/Toolheads/mosquito_sherpa_mini_frontclip_rev1_x1.STL

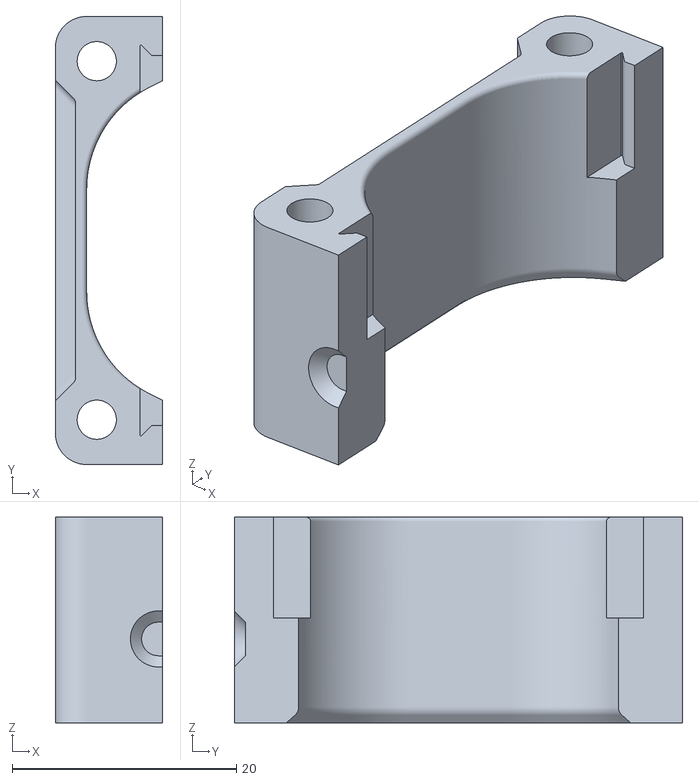
[picture p69: CAD file, 2021-01-14]
STLs/Gantry/Toolheads/mosquito_sherpa_mini_frontclip_rev1_x1.STL
9.58 x 40.0 x 18.4
