Annex-Engineering/Denali/STLs/Gantry/XY_Joints/[a]_xy_joint_idler_spacer_x2_Rev1.stl

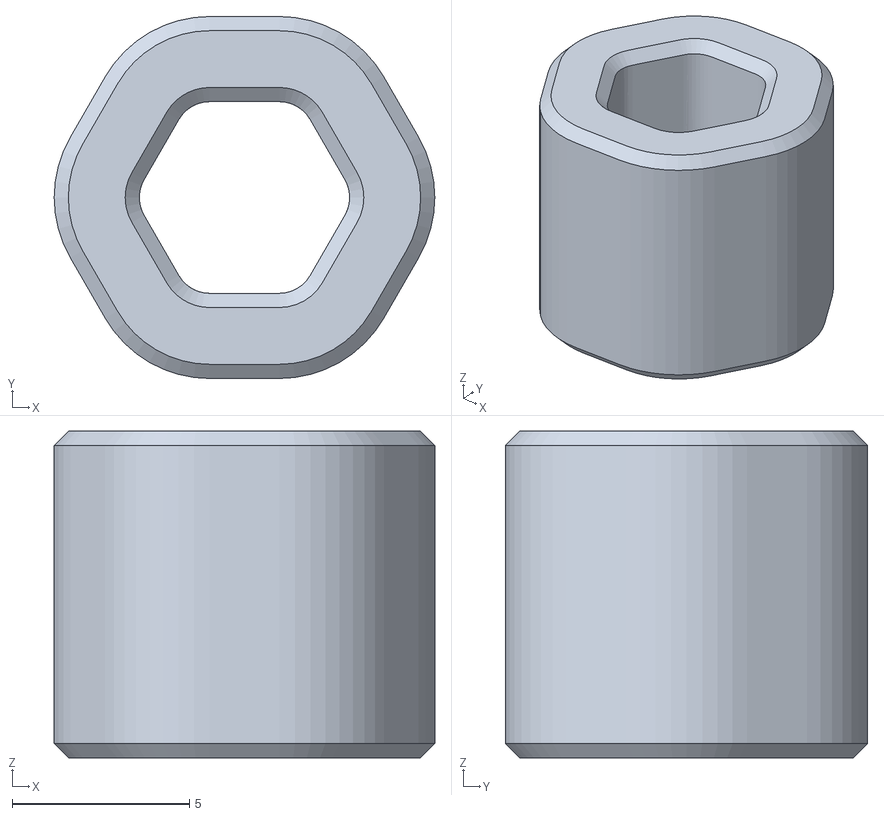
[picture p70: CAD file, 2020-09-06]
STLs/Gantry/XY_Joints/[a]_xy_joint_idler_spacer_x2_Rev1.stl
10.7 x 10.2 x 9.20
