Annex-Engineering/Denali/DXFs/Panels/Back_Panel_350mm_Rev1.DXF

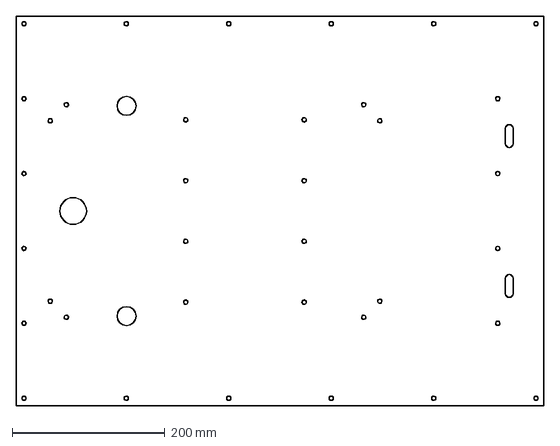
[picture p71: CAD file, 2020-09-06]
DXFs/Panels/Back_Panel_350mm_Rev1.DXF
690.0 x 510.0 mm
