Annex-Engineering/Denali/STLs/Electronics_Brackets/universal_rpi_mounting_bracket_a_x2_rev3.STL

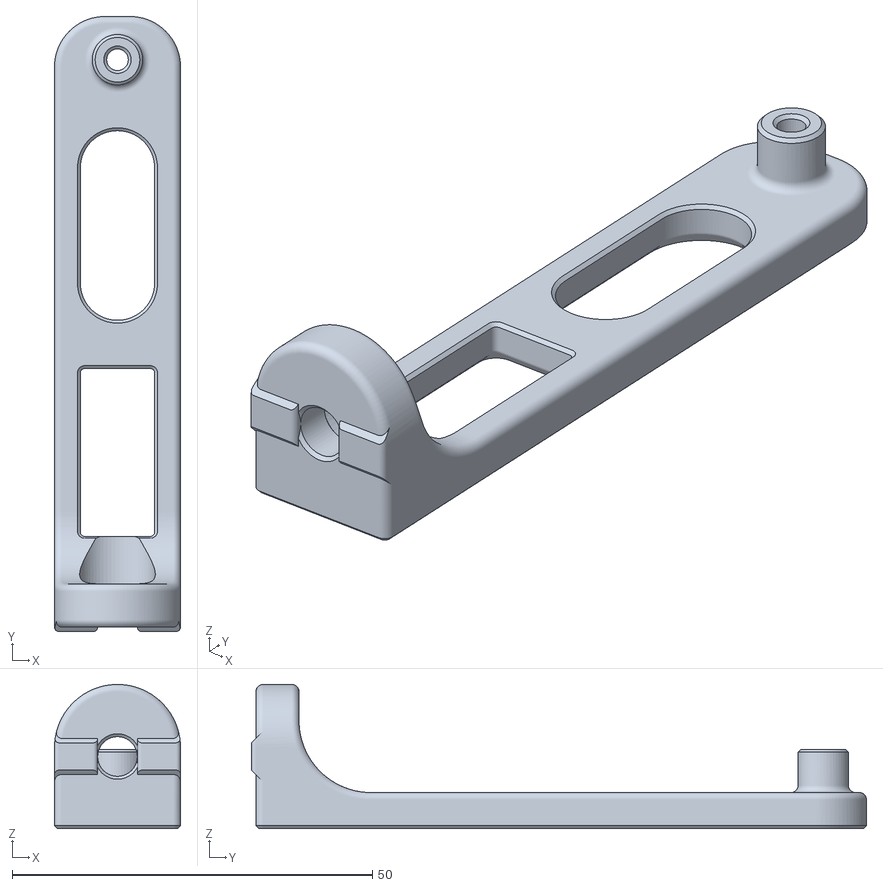
[picture p73: CAD file, 2021-11-02]
STLs/Electronics_Brackets/universal_rpi_mounting_bracket_a_x2_rev3.STL
17.5 x 85.4 x 20.0
