Annex-Engineering/Denali/STLs/Gantry/Toolheads/4010_cooling_duct_focussed_right_rev1_x1.stl

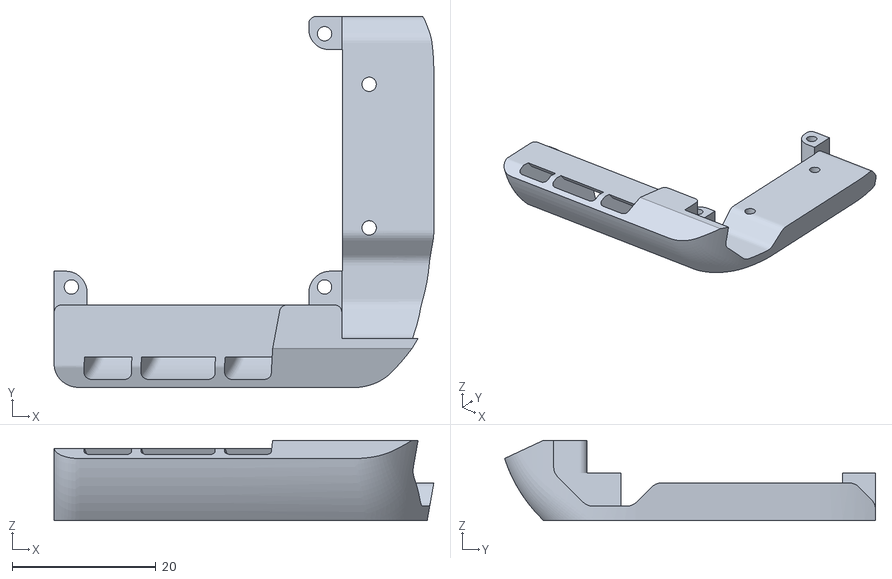
[picture p74: CAD file, 2021-01-14]
STLs/Gantry/Toolheads/4010_cooling_duct_focussed_right_rev1_x1.stl
52.8 x 51.6 x 11.1
