Annex-Engineering/Denali/DXFs/Skirts/Side_Skirt_250mm_Rev2.DXF

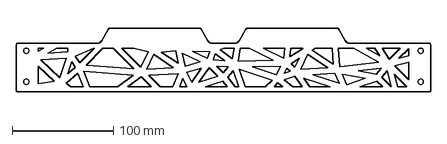
[picture p75: CAD file, 2020-09-06]
DXFs/Skirts/Side_Skirt_250mm_Rev2.DXF
410.0 x 63.0 mm
