Annex-Engineering/Denali/DXFs/Skirts/Side_Skirt_350mm_Rev2.DXF

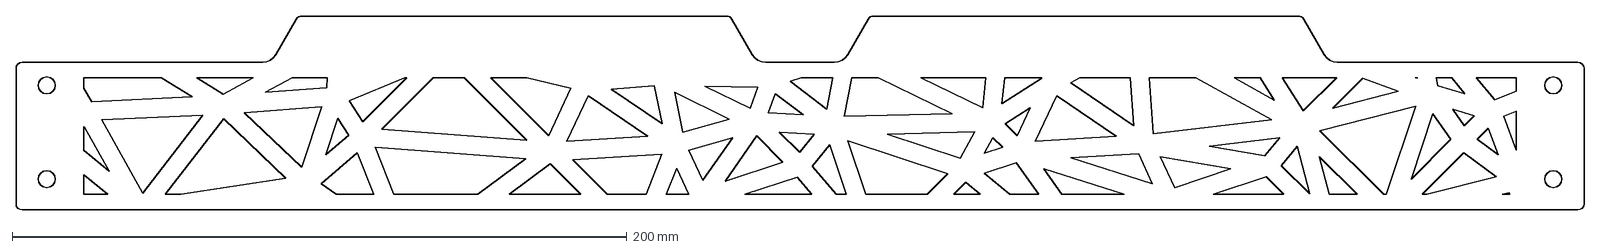
[picture p77: CAD file, 2020-09-06]
DXFs/Skirts/Side_Skirt_350mm_Rev2.DXF
510.0 x 63.0 mm
