Annex-Engineering/Denali/STLs/Electronics_Brackets/electronics_box_te_power_inlet_x1_rev1.STL

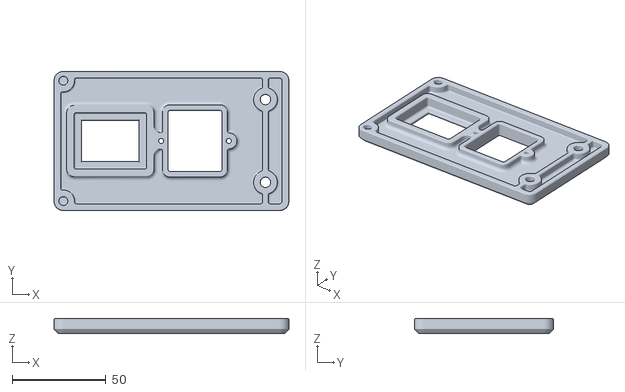
[picture p78: CAD file, 2021-08-17]
STLs/Electronics_Brackets/electronics_box_te_power_inlet_x1_rev1.STL
125.0 x 74.0 x 8.00
