Annex-Engineering/Denali/STLs/Electronics_Brackets/[a]_universal_controller_mounting_bracket_b_x2_rev1.STL

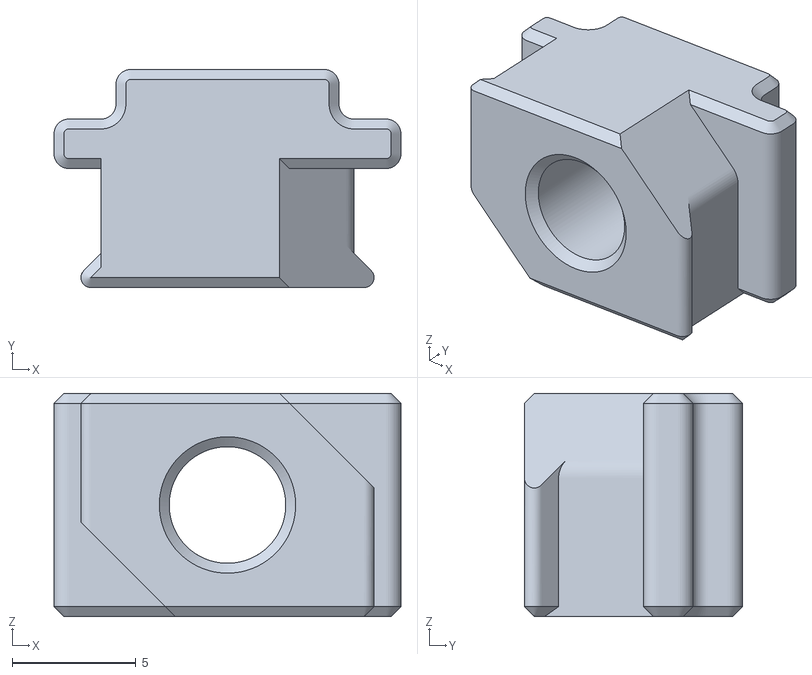
[picture p79: CAD file, 2021-08-17]
STLs/Electronics_Brackets/[a]_universal_controller_mounting_bracket_b_x2_rev1.STL
14.0 x 8.80 x 9.00
