Annex-Engineering/Denali/STLs/Electronics_Brackets/electronics_box_blanking_plate_x2_rev1.STL

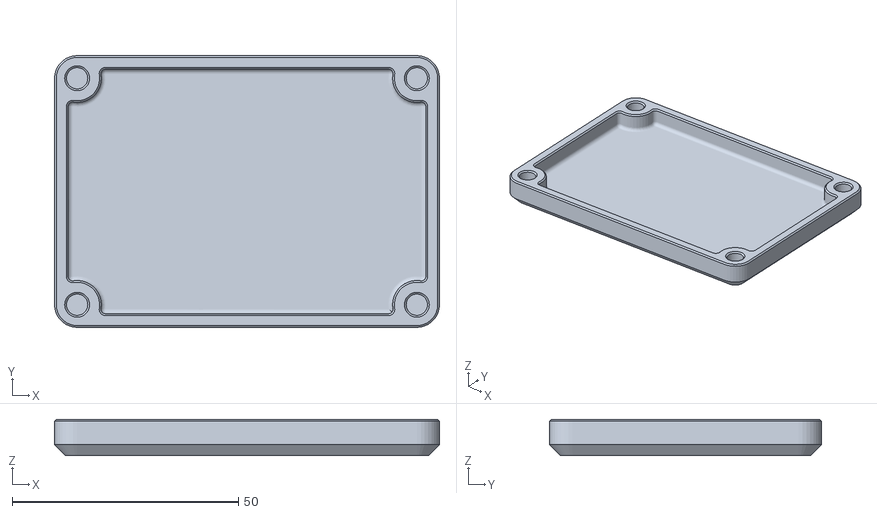
[picture p80: CAD file, 2021-08-17]
STLs/Electronics_Brackets/electronics_box_blanking_plate_x2_rev1.STL
85.0 x 60.0 x 8.00
