Annex-Engineering/Denali/STLs/Electronics_Brackets/wago_221_2x_mount_5_conductor_24VDC_x1_rev1.STL

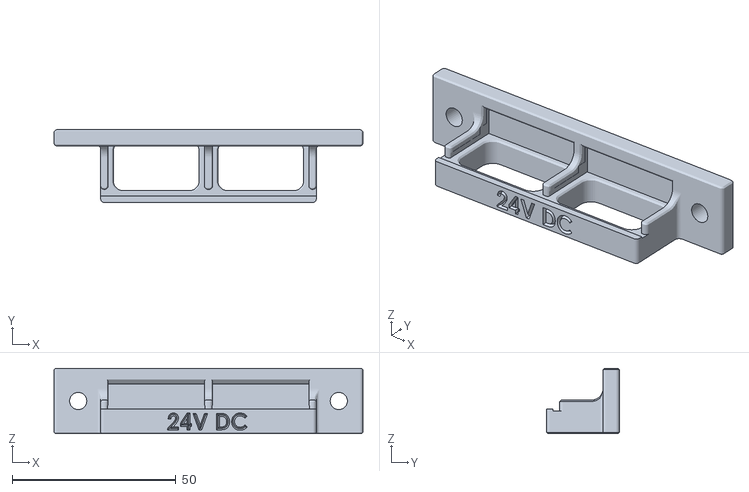
[picture p81: CAD file, 2020-09-06]
STLs/Electronics_Brackets/wago_221_2x_mount_5_conductor_24VDC_x1_rev1.STL
94.5 x 22.2 x 20.0
