Annex-Engineering/Denali/STLs/Electronics_Brackets/wago_221_3x_mount_5_conductor_120VAC_x1_rev1.STL

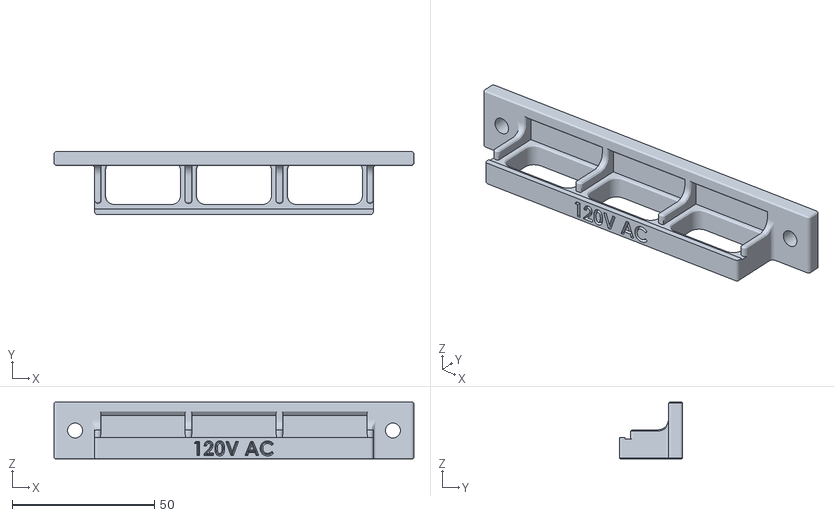
[picture p82: CAD file, 2020-09-06]
STLs/Electronics_Brackets/wago_221_3x_mount_5_conductor_120VAC_x1_rev1.STL
126.4 x 22.3 x 20.0
