Annex-Engineering/Denali/(list of files, cad)

Other CAD files:
STLs/Bed_and_Z_Drive/sfu1204_bed_pivot_joint_mirror_x2_Rev2.stl
STLs/Gantry/Front_Idlers/[a]_front_idler_a_lower_cap_x1_Rev1.stl
STLs/Gantry/XY_Joints/right_xy_joint_top_Rev4.stl
STLs/Panel_Mounting/Front_Panel_Hinges_and_Locks/Hinges/hinge_frame_top_6mm_x2_rev1.STL
STLs/Gantry/XY_Joints/right_xy_joint_bottom_Rev3.stl
STLs/Gantry/AB_Drives/a_drive_frame_lower_x1_Rev2.stl
STLs/Panel_Mounting/Side_Top_and_Rear_Panel_Quick_Release/corner_lock_body_mirror_6mm_x6_Rev2.stl
STLs/Gantry/AB_Drives/b_drive_frame_upper_x1_Rev2.stl
STLs/Gantry/Front_Idlers/[a]_front_idler_b_upper_cap_x1_Rev1.stl
STLs/Gantry/Toolheads/4010_cooling_duct_focussed_left_rev1_x1.stl
CAD/Print_Beds/Denali_Bed_200x200.x_t
CAD/Print_Beds/Denali_Bed_250x250.x_t
CAD/Print_Beds/Denali_Bed_300x300.x_t
CAD/Print_Beds/Denali_Bed_350x350.x_t
STLs/Bed_and_Z_Drive/Experimental/HD_sfu1204_ballscrew_stepper_mounting_bracket_x3_Rev1.STL
STLs/Bed_and_Z_Drive/sfu1204_ballscrew_stepper_mounting_bracket_x3_Rev1.stl
STLs/Grommets/wiring_grommet_nut_25mm_x2_rev2.STL
STLs/Grommets/wiring_grommet_nut_35mm_x1_rev2.STL
STLs/Grommets/wiring_grommet_screw_25mm_x2_rev3.STL
STLs/Grommets/wiring_grommet_screw_left_35mm_x1_rev4.STL
STLs/Grommets/wiring_grommet_screw_right_35mm_x1_rev4.STL
