Annex-Engineering/Denali/PDFs/ANNEX_Engineering_Custom_Silicone_Heaters_200mm_x_200mm.pdf

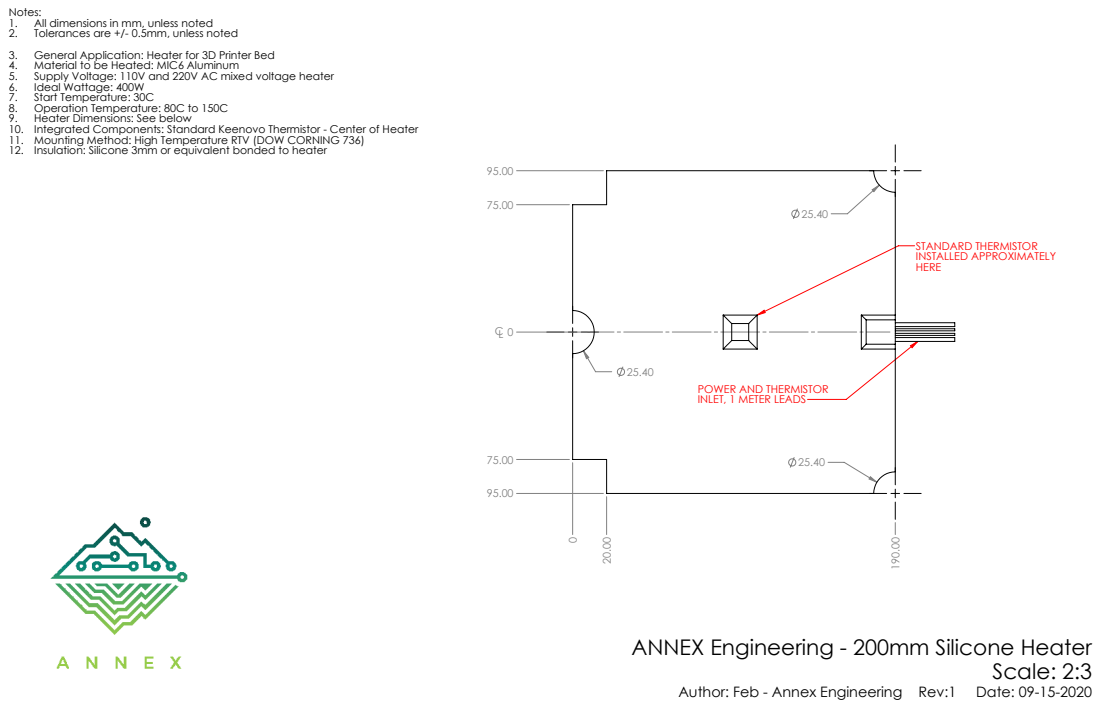
[picture p83: page 1]
STANDARD THERMISTOR INSTALLED APPROXIMATELY; Scale: 2:3

Notes:
1. All dimensions in mm, unless noted
2. Tolerances are +/- 0.5mm, unless noted
3. General Application: Heater for 3D Printer Bed
4. Material to be Heated: MIC6 Aluminum
5. Supply Voltage: 110V and 220V AC mixed voltage heater
6. Ideal Wattage: 400W
7. Start Temperature: 30C
8. Operation Temperature: 80C to 150C
9. Heater Dimensions: See below
10. Integrated Components: Standard Keenovo Thermistor - Center of Heater
11. Mounting Method: High Temperature RTV (DOW CORNING 736)
12. Insulation: Silicone 3mm or equivalent bonded to heater

POWER AND THERMISTOR
INLET, 1 METER LEADS

ANNEX Engineering - 200mm Silicone Heater

Author: Feb - Annex Engineering Rev:1 Date: 09-15-2020
