Annex-Engineering/Denali/PDFs/Denali_250mm_x_250mm_Bed_Drawing.PDF

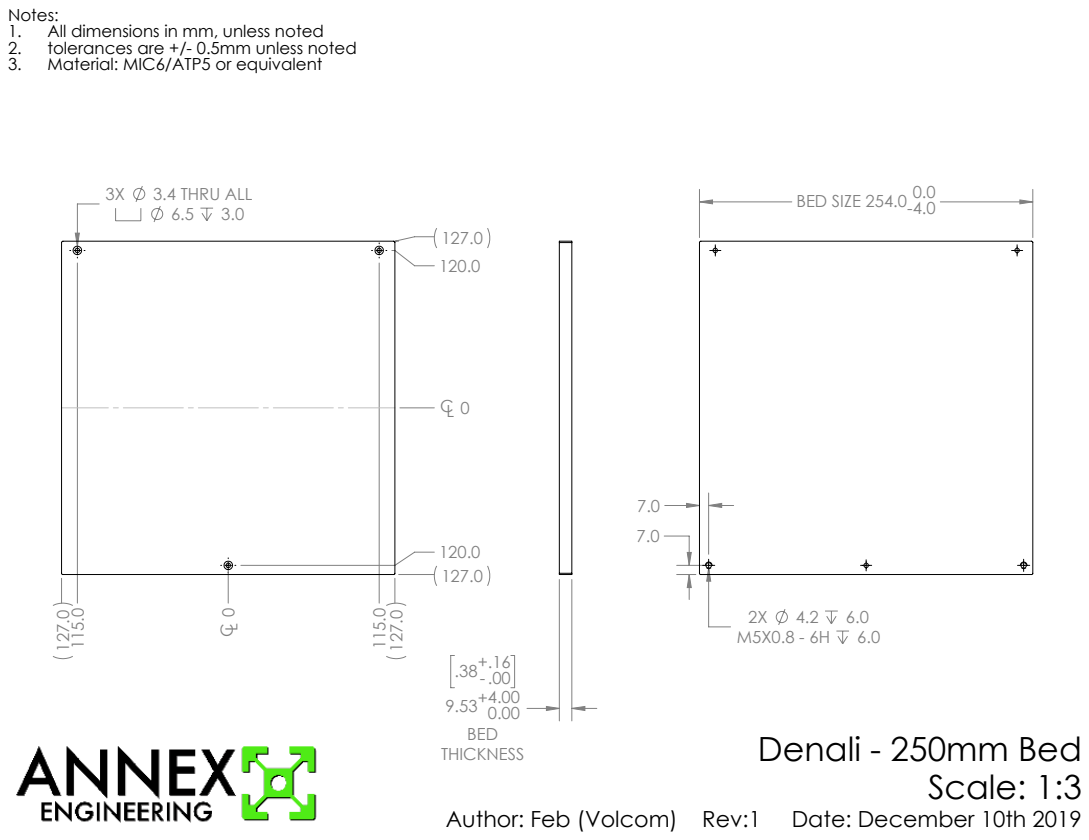
[picture p84: page 1]
3.4 THRU ALL; BED SIZE 254.0-; Denali - 250mm Bed Scale: 1:3

Notes:
1. All dimensions in mm, unless noted
2. tolerances are +/- 0.5mm unless noted
3. Material: MIC6/ATP5 or equivalent

Author: Feb (Volcom) Rev:1 Date: December 10th 2019
