Annex-Engineering/Denali/(commit log)

2020-09-06 reconstruct repo
    [Back_Panel_250mm_Rev1.DXF, Back_Panel_300mm_Rev1.DXF, Back_Panel_350mm_Rev1.DXF, Corner Magnet Panel V1.stl, Corner_Magnet_Frame_V3.STEP, Corner_Magnet_Frame_V4.STL, Deck_Panel_250mm_Rev1.DXF, Deck_Panel_300mm_Rev1.DXF]
2020-09-08 add single rail supporting magnetic v2.2 x carriage (thanks altvnk)
2020-09-16 add custom bed heaters
2020-11-04 neopixel changes
    [denali_bigtree_skr_1.3_config-250mm_x_250mm_x_200mm_build.cfg, denali_fysetc_s6_config-250mm_x_250mm_x_200mm_build.cfg]
2020-11-04 update intro to cover how to actually flash an S6
    [denali_fysetc_s6_config-250mm_x_250mm_x_200mm_build.cfg]
2020-11-19 skr1.4 config
    [denali_bigtree_skr_1.4_config-250mm_x_250mm_x_200mm_build.cfg, denali_fysetc_s6_1.2_config-250mm_x_250mm_x_200mm_build.cfg]
2021-01-14 replace existing toolheads with edwardyeeks and papejelly parts
    these are just better than the original ones, by miles
    [4010_cooling_duct_focussed_left_rev1_x1.stl, 4010_cooling_duct_focussed_right_rev1_x1.stl, V6_sherpa_mini_mount_back_rev1_x1.STL, [a]_ascender_toolhead_bowden_adapter_x1_rev1.STL, [a]_front_plate_rev1_x1.stl, [a]_toolhead_front_30mm_fan_core_rev1.STL, [a]_toolhead_front_plate_30mm_rev2.STL, [a]_toolhead_front_plate_40mm_rev1.STL]
2021-01-14 add more mounting brackets for electronics
    [[a]_electronics_box_corner_m3_inserts_x4_rev1.STL, [a]_electronics_box_m5_to_m3_screw_adapter_x24_rev1.STL, bigtreetech_skr_mounting_bracket_with_motor_expander_x1_rev3.STL, fysetc_s6_mounting_bracket_with_motor_expander_x1_rev2.STL]
2021-01-15 release 1.1 prep
    [bottom_panel_retaining_bracket_x4_Rev1.stl, led_light_bar_mount_a_x1_Rev1.stl, led_light_bar_mount_b_x1_Rev1.stl, nozzle_scrubber_holder_x1_Rev1.stl]
2021-01-15 update configs to sherpa mini and rotation distance
    [denali_bigtree_skr_1.3_config-250mm_x_250mm_x_200mm_build.cfg, denali_bigtree_skr_1.4_config-250mm_x_250mm_x_200mm_build.cfg, denali_fysetc_s6_1.2_config-250mm_x_250mm_x_200mm_build.cfg]
2021-01-16 lie part flat
    [x_carriage_left_mag_microswitch_rev1_x1.stl]
2021-03-12 add experimental HD z motor mounts to repo
    [HD_sfu1204_ballscrew_stepper_mounting_bracket_x3_Rev1.STL]
2021-03-18 add spider bracket, update electronics box corners to match other printers
    [[a]_electronics_box_corner_m3_inserts_x4_rev1.STL, [a]_electronics_box_corner_x4_rev3.STL, [a]_electronics_box_corner_x4_rev4.STL, [a]_electronics_box_m5_to_m3_screw_adapter_x24_rev1.STL]
2021-05-22 update brackets to use heatserts
    [bigtreetech_skr_mounting_bracket_x2_rev3.STL, bigtreetech_skr_mounting_bracket_x2_rev4.STL, duet2_+_duex5_mounting_bracket_x2_rev2.STL, fysetc_s6_mounting_bracket_with_motor_expander_x1_rev2.STL, fysetc_s6_mounting_bracket_x1_rev4.STL, fysetc_s6_mounting_bracket_x2_rev3.STL]
2021-05-27 better rpi brackets
    [raspberrypi_mounting_bracket_for_heatsink_x1_rev1.STL, raspberrypi_mounting_bracket_x1_rev1.STL]
2021-05-27 add vertical variant of spider mounting bracket to allow dual controllers in standard electronics box
2021-05-29 shorten stack height of rpi bracket to better fit on k3 printers
2021-05-29 update electronics box corners to be universal with k3
    [[a]_electronics_box_corner_x4_rev4.STL]
2021-05-30 add vertical variant of rs-25-5 bracket
    [meanwell_rs_25_5_psu_mounting_bracket_horizontal_x1_rev2.STL]
2021-05-30 move skr to legacy folder
    [bigtreetech_skr_mounting_bracket_x2_rev4.STL]
2021-05-31 bump post diameter on mounting bracket to fit better with case
    [raspberrypi_mounting_bracket_for_heatsink_horizontal_x1_rev3.STL, raspberrypi_mounting_bracket_for_heatsink_vertical_x1_rev2.STL]
2021-06-13 add print bed cad
    [Denali_Bed_200x200.x_t, Denali_Bed_250x250.x_t, Denali_Bed_300x300.x_t, Denali_Bed_350x350.x_t]
2021-08-04 update denali configs to support dockable probe, k series macros, input shaper and moonraker style UIs
    [denali_bigtree_skr_1.3_config-250mm_x_250mm_x_200mm_build.cfg, denali_bigtree_skr_1.4_config-250mm_x_250mm_x_200mm_build.cfg, denali_fysetc_s6_1.2_config-250mm_x_250mm_x_200mm_build.cfg]
2021-08-16 wiring grommets are easier to print, assemble and install
    [wiring_grommet_nut_25mm_x2_rev1.STL, wiring_grommet_nut_25mm_x2_rev2.STL, wiring_grommet_nut_35mm_x1_rev1.STL, wiring_grommet_nut_35mm_x1_rev2.STL, wiring_grommet_screw_25mm_x2_rev3.STL, wiring_grommet_screw_left_25mm_x2_rev2.STL, wiring_grommet_screw_left_35mm_x1_rev3.STL, wiring_grommet_screw_left_35mm_x1_rev4.STL]
2021-08-17 add experimental electronics brackets
    [electronics_box_blanking_plate_x2_rev1.STL, electronics_box_te_power_inlet_x1_rev1.STL, universal_controller_mounting_bracket_a_x2_rev1.STL, universal_controller_mounting_bracket_b_x2_rev1.STL, universal_meanwell_lrs_psu_mounting_bracket_x2_rev1.STL, universal_meanwell_rs_psu_mounting_bracket_x2_rev1.STL, universal_meanwell_uhp_psu_mounting_bracket_x2_rev1.STL, universal_rpi_mounting_bracket_a_x2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]
2021-08-17 add readme to new electronics brackets folder
2021-08-20 mirror rpi bracket
    [universal_rpi_mounting_bracket_a_x2_rev1.STL, universal_rpi_mounting_bracket_a_x2_rev2.STL]
2021-08-21 make universal controller bracket 15mm longer
    [universal_controller_mounting_bracket_a_x2_rev1.STL, universal_controller_mounting_bracket_a_x2_rev2.STL]
2021-10-29 update rpi_temperature to use temperature_host, as was deprecated
    [denali_bigtree_skr_1.3_config-250mm_x_250mm_x_200mm_build.cfg, denali_bigtree_skr_1.4_config-250mm_x_250mm_x_200mm_build.cfg, denali_fysetc_s6_1.2_config-250mm_x_250mm_x_200mm_build.cfg]
2021-10-29 remove default parameters from config
    [denali_bigtree_skr_1.3_config-250mm_x_250mm_x_200mm_build.cfg, denali_bigtree_skr_1.4_config-250mm_x_250mm_x_200mm_build.cfg, denali_fysetc_s6_1.2_config-250mm_x_250mm_x_200mm_build.cfg]
2021-11-02 fix electronics brackets hole alignment
    [[a]_universal_controller_mounting_bracket_b_x2_rev1.STL, [a]_universal_rpi_mounting_bracket_b_x2_rev1.STL, universal_controller_mounting_bracket_a_x2_rev2.STL, universal_controller_mounting_bracket_a_x2_rev3.STL, universal_rpi_mounting_bracket_a_x2_rev2.STL, universal_rpi_mounting_bracket_a_x2_rev3.STL]
2021-11-02 print orientation
    [universal_controller_mounting_bracket_a_x2_rev3.STL, universal_rpi_mounting_bracket_a_x2_rev3.STL]
2021-12-03 move user mods to new repo
    [Corner Magnet Panel V1.stl, Corner_Magnet_Frame_V3.STEP, Corner_Magnet_Frame_V4.STL, Magnet Mounts v3.step, PI Mount Body.stl, PI Mount Tab x3.stl, PI Mount big tab.stl, Panel Insert.stl]
2022-01-26 diamond electronics box corner
    [[a]_electronics_box_corner_x4_rev6.STL]
2022-02-01 reorient print orientation for power supply brackets (per kmobs)
    [[a]_electronics_box_corner_x4_rev6.STL, universal_meanwell_lrs_psu_mounting_bracket_x2_rev1.STL, universal_meanwell_lrs_psu_mounting_bracket_x2_rev2.STL, universal_meanwell_rs_psu_mounting_bracket_x2_rev1.STL, universal_meanwell_rs_psu_mounting_bracket_x2_rev2.STL, universal_meanwell_uhp_psu_mounting_bracket_x2_rev1.STL, universal_meanwell_uhp_psu_mounting_bracket_x2_rev2.STL]
2022-02-11 who would have thought a lrs-200 had m4 holes
    [[a]_electronics_box_corner_x4_rev6.STL, [a]_universal_controller_mounting_bracket_b_x2_rev1.STL, [a]_universal_rpi_mounting_bracket_b_x2_rev1.STL, [a]_wiring_retaining_clip_x10_rev1.STL, bigtreetech_skr_mounting_bracket_x2_rev4.STL, electronics_box_blanking_plate_x2_rev1.STL, electronics_box_te_power_inlet_x1_rev1.STL, fysetc_s6_mounting_bracket_x1_rev4.STL]
2022-02-27 m3 insert was 5mm, now 4.7mm hole
    [[a]_electronics_box_corner_x4_rev6.STL, [a]_electronics_box_corner_x4_rev7.STL]
